NikhilMSeb/ECE445-FA21-Solar/src/445-website/README.md

This folder contains all the code used to design and implement the Django framework front-end and back-end for this project. \
(Running server at this folder level will start the project on localhost!)
