NikhilMSeb/ECE445-FA21-Solar/notebooks/sydneyl3/README.md

# ECE 445 Lab Notebook: Sydney Li

## Entries 
[08/24/2021: Project Ideas and Team Finding](#08242021-project-ideas-and-team-finding) \
[08/25/2021: Gathering Additional Information](#08252021-gathering-additional-information) \
[08/30/2021: Finding a Third Member](#08302021-finding-a-third-member) \
[09/01/2021: First Meeting With Professor Banerjee](#09012021-first-meeting-with-professor-banerjee) \
[09/08/2021: Solar Panel Research](#09082021-solar-panel-research) \
[09/13/2021: First TA Meeting](#09132021-first-ta-meeting) \
[09/14/2021 - 09/15/2021: Microcontroller Research and Design Proposal](#09142021---09152021-microcontroller-research-and-design-proposal) \
[09/17/2021: ESP32 Microcontroller](#09172021-esp32-microcontroller) \
[09/22/2021 - 09/26/2021: First Design Document Draft](#09222021---09262021-first-design-document-draft) \
[09/27/2021: Design Document Check and Rooftop Visit](#09272021-design-document-check-and-rooftop-visit) \
[09/30/2021: Final Version of Design Document](#09302021-final-version-of-design-document) \
[10/07/2021: PCB Schematic Updates](#10072021-pcb-schematic-updates) \
[10/12/2021: Power Subsystem LTSpice Simulations](#10122021-power-subsystem-ltspice-simulations) \
[10/19/2021: Additional PCB Updates](#10192021-additional-pcb-updates) \
[10/21/2021: Implementing the Darlington Array](#10212021-implementing-the-darlington-array) \
[10/27/2021: Design Document Updates](#10272021-design-document-updates) \
[10/29/2021: Finalized Relay Subsystem](#10292021-finalized-relay-subsystem) \
[10/30/2021: PCB Completion](#10302021-pcb-completion) \
[11/07/2021: Drafting the Design Aspect of the Final Paper](#11072021-drafting-the-design-aspect-of-the-final-paper) \
[11/12/2021: Researching the Hardware Communication Aspect of the ESP32](#11122021-researching-the-hardware-communication-aspect-of-the-esp32) \
[11/14/2021: Researching the Hardware Communication Aspect of the ESP32 Part II](#11142021-researching-the-hardware-communication-aspect-of-the-esp32-part-ii) \
[11/19/2021: Part Testing Prior to PCB Arrival](#11192021-part-testing-prior-to-pcb-arrival) \
[11/24/2021: PCB Retrieval and Additional Testing](#11242021-pcb-retrieval-and-additional-testing) \
[11/29/2021: ADC Testing and New Problems](#11292021-adc-testing-and-new-problems) \
[11/30/2021: Fixes and Current Sensor Calibration](#11302021-fixes-and-current-sensor-calibration) \
[12/01/2021: Culmination of the Monitoring Subsystem](#12012021-culmination-of-the-monitoring-subsystem) \
[12/02/2021: Final Demo Presentation](#12022021-final-demo-presentation)

## 08/24/2021: Project Ideas and Team Finding
**Objectives:** Find a team and choose a good project idea to work on over the semester.

**Outcome:** Discovered a mutual friend in the course, Maram Safi and we had similar interests in the project that we wanted to work on. We had already met prior to the course and were taking similar classes this semester. Namely, ECE464 (Power Electronics) and ECE469 (Power Electronics Lab) taught by professor Arijit Banerjee. During the first class meeting, professor Banerjee proposed the idea of a group of students taking on the project working with the research panels on top of ECEB. The project is to implement a smart interface box with protection measures in place to prevent overcurrent, overvoltage, and to shut down the whole operation if temperatures exceed the expected threshold. Since professor Banerjee discussed that this semester, he planned on implementing new labs for ECE469 so that students could do power conversion while harvesting energy from the research panels at an undergraduate level, we thought it would be a great idea if the coursework for this class along with our Power Electronics Lab could go hand-in-hand. As Maram Safi and I are electrical engineers, we need to find a partner that is a computer engineer with advanced software capability and to design a website to fulfill the purposes of the web design and user interface that Professor Banerjee mentioned. There was another group of students who took on this project for their senior design in the Fall 2019 semester but there were certain problems with the design that needed to be solved. There were issues with scalability, to clarify, we hope to soon have a meeting with professor Banerjee and pitch our idea on the RFA board for approval to see if this project within the scope of the course. We hope to ask professor Banerjee for more information in the upcoming days. Another issue to be resolved is the ethernet dependence. The previous design for this project utilized Ethernet to provide communication capability between a portal and the microcontroller of the smart interface box. Professor Banerjee emphasized wireless capabilities and to design a user-friendly website that can be used to configure the solar panels. 

## 08/25/2021: Gathering Additional Information 
**Objectives:** Study professor Banerjee's powerpoint to further my understanding on the project and how brainstorm some ideas or a high level picture as to how we can possibly accomplish it.

**Outcome:** There will be an external 12V power supply available to help us power our smart interface box. There will be four solar panel external inputs coming into the box and two external outputs leading out into a distribution box. The premises for our design will have to measure the voltage, current, temperature, and possibly additional information. Protection measures will have to be instilled. The project has to be scalable meaning that more than one panel's information will be collected on the back-end server of our website.

* Sunpower SPR-425E-WHT-D (425W) Solar Panel

interfacebox

## 08/30/2021: Finding a Third Member 
**Objectives:** Compose our RFA and find a third member for our group.

**Outcome:** Maram and I posted an RFA on the web board stating the premises of what we understand for the project so far. We plan on getting additional information from professor Banerjee on September 1 when he has office hour availabity. A few very talented individuals had requested to join our group and ultimately, we thought that Nikhil would be the best fit for us because he had experience with web design which is one of the key designs that we want for the project. We met this week to establish some form of communication and to understand each others work ethics before taking on this project.

## 09/01/2021: First Meeting With Professor Banerjee
**Objectives:** Meet with professor Banerjee collectively as a group to understand the scope of the project, any additional information or features we will have to implement, and clarify specific details. 

**Outcome:** We were able to meet in Professor Banerjee's office and he mentioned a few things for our project that we should be aware. Prior to the meeting, we understood that there had been a design done during the Fall 2019 semester by a group of students. The issue is that when another senior design group tried to built upon their project, it was a mess because of poor documentation. Therefore, he emphasized that good documentation for our project must be done so in the event that the design is not incomplete or to be improved upon, there will be another group of students who can understand the documentation and to built the project themselves. Another thing is that in order to encourage creativity, we will not be basing our design on the past design as it will bias our thinking and we may run into the issue with scalability again. One thing that I had clarified that I did not know before is that I was under the impression that it would be one interface box responsible for communicating multiple solar panel information but there will be 60 boxes mounted on each solar panel but the scability issue comes from collectively representing multiple solar panel data on the website. He also mentioned that if we go above and beyond with the features we implement, we could possibly implement drones to take thermal images of the solar panels on the roof to provide snapshot data for the users that will use the website from the atrium. 

**Key Takeaways:**
* Build our project from scratch without prior information to encourage creativity
* The scalability and wireless connectivity is a key requirement 
* If these features can be implemented, we can possibly add some more advanced features such as drone thermal imaging

## 09/08/2021: Solar Panel Research
**Objectives:** Brainstorm ideas about the design and research ratings for the solar panels.

**Outcome:** Since the smart interface requires wireless capability, we will need a microcontroller that is able to wirelessly communicate. I am looking into possible microcontrollers that we can use while also being able to have voltage reading capability. Professor Banerjee mentioned that he wanted a more advanced protocol than just arduino to build the website. As the solar panel will connect to the external load, we will need an inverter if that load is an AC grid. A power converter to handle those ratings is necessary and therefore, it is important to understand the max ratings that we can expect to receive with the panel. Professor Banerjee said that to configure the different cells for the solar panel, they are utilizing relays and already have a relay subsystem built to use since the relays are already purchased and can withstand the high voltage from the solar panels. A relay is an switch that closes when the coil is energized and producing an electromagnetic field to close the switch.

* Solar Panel Ratings

sunpower spr-425e-wht-d

## 09/13/2021: First TA Meeting
**Objectives:** Meet our TA and understand the schedule for the upcoming week and a outline of how we can create our project.

**Outcome:** Prior to the meeting, we drafted parts of the proposal that we wanted to show and our TA, Evan Widloski, was able to give us pointers on things that we should consider when building our design. The important thing was to specify our high level requirements and what we hope to achieve with the project. I made a first draft of our block diagram mapping out the design flow and there were many points and specifics that had to be improved upon. A key was to clarify that only one box is to be mounted per solar panel and to capture the solar parameters from there. We labelled different subsystems that we would need. Namely a power subsystem to power up the microcontroller, a power inverter to supply power to the grid, a monitoring subsystem for measuring the voltage and current. Evan suggested that we should do more research on how voltage and current readings are done when not utilizing lab equipment. Methods such as analogRead() on an arguino to measure voltage is one example. Another key bit of information that Evan mentioned would help us with our project is to look at other similar projects that have been done to understand how we can design our own. One mistake that I had made when creating this draft is that the subsystem for wireless communication would be built into our microcontroller. Since we have not decided on a microcontroller at the moment, there was a lot of room for improvement. Many of the designs for the block diagram are not specified and we hope to clarify that in our proposal. We also created a git repository for storing our journal entries. To mediate a lot of the confusion, Evan suggested that we should go onto the ECEB roof to understand and observe which external connections will be provided to us to plan around our design flow. We will email Professor Banerjee to schedule a time with him so that we can observe the rooftop solar panels. 

* First Block Diagram Draft

firstblockdiagram

## 09/14/2021 - 09/15/2021: Microcontroller Research and Design Proposal
**Objectives:** Do research about how similar projects like ours were completed and complete the design proposal. Research possible microcontrollers that can provide us with a wireless interface.

**Outcome:** When doing research upon similar projects monitoring voltage and current from solar panels, I found multiple different MPPT projects utilized to charge lithium batteries. Some similar ones are linked below: 
* [IoT Based Solar Panel Power Monitoring using ESP32 and ThingSpeak](https://circuitdigest.com/microcontroller-projects/iot-solar-panel-power-monitoring-system-using-esp32-and-thingspeak)
* [DIY 1kW Arduino MPPT Solar Charge Controller (WiFi ESP32)](https://www.instructables.com/DIY-1kW-MPPT-Solar-Charge-Controller/)
* [DIY Solar Panel Monitoring System - V1.0](https://www.instructables.com/DIY-Solar-Panel-Monitoring-System-V10/) \
The general consensus when choosing a microcontroller best suited for the needs of monitoring multiple solar panel parameters at a low cost was the ESP32 microcontroller which is what we decided to use. The ESP32 has IoT-enabled application and it will be able to process the data from its analog pins and send the data via any kind of connection protocol such as Wi-Fi or to the cloud server. We specifically selected ESP32 as it is a low-cost microcontroller with tons of features. Also, it has a built-in Wi-Fi radio through which we can connect to the internet very easily.
The second order of business is to understand how voltage and current are going to be read from the solar panels. Since the voltage from the solar panel can be as high as 85.6V in our case, we need a voltage divider to step down the voltage so that the voltage divider output voltage should not exceed the microcontroller maximum I/O voltage (3.3V for ESP32). The output value will be read with one of the analog inputs of Arduino and its analogRead() function. That function outputs a value between 0 and 4095 that is 3.3/4095 for each increment. For current sensing, we can utilize the [Allegro ACS723 current sensor IC](https://www.allegromicro.com/en/products/sense/current-sensor-ics/zero-to-fifty-amp-integrated-conductor-sensor-ics/acs723). It's an economical and precise solution for AC or DC current sensing and good for space constrained applications while also saving costs due to reduced board area. It's typical applications includes overcurrent fault protection which is a key feature of our project.
I also updated our block diagram to specify our subsystems a bit more and to identify which lines represent data or power. The high level requirements I thought that the project should have would be to involve the accuracy of monitoring the solar panel parameters along with wireless capability and scability. I also included what we can expect out of each of the subsystems within the block diagram and specified a bit more of what parts should be included in each. The final document that we put together and submitted can be found within this repository [here](https://github.com/NikhilMSeb/ECE445-FA21-Solar/blob/main/team%20documents/ECE%20445%20Proposal.pdf)

* Second Block Diagram Draft

secondblockdiagram

## 09/17/2021: ESP32 Microcontroller
**Objectives:** Research more specific details and benefits using the ESP32 microcontroller over other microcontrollers. Possible safety concerns will also be crucial to consider when working with high voltages. 

**Outcome:** 
* [ESP32](https://cdn.sparkfun.com/datasheets/IoT/esp32_datasheet_en.pdf) 
  * Wireless Microcontroller (ESP32 MCU): Wi-Fi Connectivity within a large radius. Operates at a temperature range from -40°C to 105°C. 
    * Performs more accurate DC voltage measurements (Analog to Digital Converters with Higher Resolution) - Eighteen 12-bit ADCs
    * Replaced our original design of utilizing an arduino for analog to digital conversion to measure voltage and current 
  * Power Subsystem consists of a Step-Down Buck Converter: Utilized to step down the DC-DC voltage to power up 3.3V/5V LEDs, switches, etc. 
  * Does Digital to Analog and Analog to Digital Conversion
* [ESP8266](https://www.espressif.com/sites/default/files/documentation/0a-esp8266ex_datasheet_en.pdf)
  * Few GPIO pins in which if we utilize a lot of hardware, we will run out of pins
  * 4MB of data storage (unnecessary for our project)
* [WINC1500](https://media.digikey.com/pdf/Data%20Sheets/Microchip%20PDFs/ATWINC15x0.pdf)
  * Low power mobile applications
    * Features: Power amplifier, LNA, Switch and Power Management
    * On chip microcontroller and integrated flash memory for system software
* [Panasonic PAN9520](https://www.mouser.com/pdfDocs/WMPAN9520ProductSpecification.pdf)
   * Many features that we don't need
    * High performance CPU, high sensitivity wireless radio, baseband processor, etc.
    * Out of stock
    * 2.4 GHz WiFi
    * Supports 20MHz and 40MHz bandwidths in 2.4GHz band 

**Safety Concerns:**
* Arc Flashes - Flash Burn and Blast Hazards
* Electric Shock, with particular scrutiny on faulty wiring as well 
* Falls - due to the location itself of the solar panels for this project (ECEB roof)
* Thermal Burn Hazards
* Over-current/voltage - ideally will be directly countered by our interface box 

## 09/22/2021 - 09/26/2021: First Design Document Draft
**Objectives:** Complete our first draft of the Design Document and add any missing information so that the ECE445 course staff can evaluate and provide us with feedback in order to improve our design.

**Outcome:** I was able to do more research about the design structure for the individual subsystems and provided the requirements and verifications for all the hardware aspect of the project. I created a first draft of the PCB schematic so that we have some notion of the parts we may need. The cost analysis was also done when I was considering the base parts that we would need for the structure of the project. Other passive compoenents are missing at the moment and will be added upon and updated as we work through more of the PCB schematic. To demonstrate that we can have 2 interface boxes that can communicate with one another and that the project can be scaled up to multiple panels, our costs would have essentially doubled meaning that we would need to buy 2 of everything. A schedule was also worked out so that I would know what to expect to work on and what deadlines we would try to meet over the next few weeks.

* First PCB Schematic Draft:
firstdraftPCB

* 3 High-Level Requirements: 
   * Interactive Web Design
   * Wireless Communication Capability with the Solar Panels
   * Scalability
* Subsystem Requirement: 
   * Manual Switch Control

* Different Components & Subsystems
   * External 12V Power Supply Unit:
   * Power Subsystem: DC-DC Converter (Possibly a step-down buck converter)
   * Wireless Microcontroller - Control system (Monitors Voltage/Current, communicates that data to our external display, etc.)
   * LED or Hexadecimal Display - Displays whether a wireless connection has been established. Whether power is being integrated into the grid
   * Thermocouples - Monitors the temperature of the panels
   * Switches - Providing external control toward the interface box
   * Monitoring Subsystem - Retrieves voltage/current data from the panels. If overvoltage/overcurrent occurs, implements safety precautions and shuts down completely
   * Communication Subsystem - Capability of interfacing with multiple solar panels. Be able to select the combination of cells to output to the interface (32/64/128 cells)
   * DC-AC Power Inverter - Transfers AC power to the external load (Must be load independent)
            
The uploaded first draft of the Design Document for our project can be found on the ECE 445 Projects page (Team #10) [here](https://courses.engr.illinois.edu/ece445/getfile.asp?id=19521)

## 09/27/2021: Design Document Check and Rooftop Visit
**Objectives:** Meet with Professor Schuh and other TAs to discuss our Design Document progress and further improvements that we can make prior to the design review. Also observe the solar panels on the ECEB rooftop and observe the inputs that will be going into our box and a 12V supply that we will be using. Understand how the boxes will be mounted and which external load the smart interface box will supply. 

**Outcome:** During our design document check with Professor Jonathon Schuh, TA's David Null and Bonhyun Ku, we were able to receive very good feedback on our design document.
The following changes that need to be made include: 
* Have more distinguished subsystems in our block diagram and make it easier for an engineer to look at the block diagram and understand how the design flow operates
* Provide more specific details on our high level requirements such as a
* Include a tolerance range with voltage, current, and temperature readings when testing in our Requirements and Verifications table
* Create a better visual aid in which we can understand how the boxes are mounted onto each panel (After the rooftop visit, we have an understanding on how we can visually represent that)
* Do not use green at all to represent the power flow in the block diagram as it may not be visible on a presentation
* Draft more of the PCB design schematics prior to our PCB board reviews
* Have multiple references cited in IEEE format (around 20 is expected)
* Reformat the tolerance analysis 
* Ensure that each image has a figure attached on the bottom and that tables have a caption

As for the rooftop visit guided by Kevin Colravy, he was able to take us to observe the relay boards that they had already attached to the solar panels. They created boards solely used for configuring the solar panels and these boards consist of the relay configuration that professor Banerjee suggested we utilize in our own project. There are 10 dummy boxes are already attached to the solar panels but are currently not harvesting energy to the grid. As for the external load that we will be supplying, it is purely a passive load mainly composed of resistors so output behavior can be observed and there is no storage capability so although they have the capability of transferring power to the grid, this functionality is not currently active.

* Relay Board Utilized Solely for Configuring the Solar Panels:
attabox

As for adding more details to our PCB design, we are looking for specific parts such as a buck converter when creating our power subsystem (some considerations):
* HiLetgo 5pcs DC-DC 12V to 3.3V 5V Power Module 3.3V 5V 12V Multi Output Voltage Conversion 
   * Converts a 12V dc input to 2 separate 3.3V and 5V dc outputs
* Originally Considering XL7015 dc-dc buck converter module but it converts a maximum voltage rating of 80V to 5V. 2 Issues:
   * The open circuit voltage when operating at 128 cells exceeds 80V (85.6V)
   * There is no option to step down to 3.3V as needed for input voltage for the temperature sensor

With additional research on the full capabilities of the Allegro ACS723 current sensor. It uses a Hall effect sensor to output a voltage relative to the current flowing through the IP+ and IP- pins on the board. The advantage of using a Hall effect sensor, specifically, is that the circuit being sensed and the circuit reading the sensor are electrically isolated meaning that, although your Arduino is running on 5V, the sensed circuit can be operating at higher DC or AC voltages. The Current Sensor Breakout measures both DC and AC currents all the way up to 5A, has full electrical isolation of measured and sensed circuits, and has a base sensitivity of 400mV/A. Although the analog output is adjustable to 80kHz, the bandwidth on the ACS723 Sensor Breakout width filter has been set to 20kHz to reduce noise when using at high gains. The full 80KHz bandwidth that the sensor is capable of can be recovered by closing the JP1 (Bandwidth Select) jumper on the back of the board.
* Note: Although the chip itself is rated for up to 2.4kV (RMS) of isolation, the board has not been designed for such high voltage applications.

## 09/30/2021: Final Version of Design Document
**Objectives:** Update the Design Document utilizing the feedback that we got during our Design Document check and preparing for the final design review. We want to make sure there are no outstanding issues with our design before we handle the completion of the PCB. 

**Outcome:** Further completion of our verifications. Look at which parts are in stock and adjust our PCB schematics on parts that we have available. We removed the ACS723 current sensor and replaced it with a similar [ACS714 current sensor](https://www.digikey.com/en/product-highlight/a/allegro-microsystems/acs714-automotive-grade-hall-effect-current-sensor). Gate drivers were unavailable so we had to adjust our relay configuration.
* [POWER SUBSYSTEM](https://www.ti.com/lit/ds/symlink/lm1117.pdf?HQS=dis-dk-null-digikeymode-dsf-pf-null-wwe&ts=1634572215589):
    * 12V Power Supply:
        * DC Output 12V - May vary ~12V range
        * Step Down Buck Converter (12V to 5V): Constant DC output ~5V range
        * Step Down Buck Converter (12V to 3.3V): Constant DC output ~3.3V range
* [SWITCHING SUBSYSTEM](https://www.mouser.com/datasheet/2/164/ftr_j2-967.pdf):
    * Relay: Open Circuit Test (4 Different Combinations) - Input - Solar Panel (DC Input into Relay - DC Output out of Relay)
        * DC (128 Cells) - AD Configuration: Open Ckt Voltage = 85.6V ± 2V DC Output w/ Variability
        * DC (64 Cells) - BC Configuration: Open Ckt Voltage = 42.8V ± 2V DC Output w/ Variability
        * DC (32 Cells) - CD Configuration: Open Ckt Voltage = 21.4V ± 2V DC Output w/ Variability
        * DC (0 Cells) - XX Configuration: Open Ckt Voltage = 0V 
Note: Variability means that dependent on certain conditions, this voltage will change (weather, sun exposure, etc)
* [MONITORING SUBSYTEM](https://www.digikey.com/en/product-highlight/a/allegro-microsystems/acs714-automotive-grade-hall-effect-current-sensor): 
    * Solar Panel Input: Dependent on which configuration - Output of Relay -> Voltage Divider - Current Divider goes before the Voltage Divider
        * Voltage Divider: Measures Voltage of the Open Ckt Voltage from the Relay (Expect DC Output w/ Variability)
        * Current Divider: Measures Current of the Cell Configuration - ~mA range (Small DC Current Value w/ Variability)
* [MANUAL CONFIGURATION](https://sten-eswitch-13110800-production.s3.amazonaws.com/system/asset/product_line/data_sheet/129/100.pdf): 
    * Switches: 
        * Testing: Do the switches operate how we expect? 
        * Does it change which configuration we have? When the configuration is controlled through software, which one takes precedence?
* [MICROCONTROLLER SUBSYSTEM](https://esp32.com/viewtopic.php?t=13089):
    * ESP32 Microcontroller:     
        * Does this have Wi-Fi Capability enabled?
        * Does it connect to the wireless server that we are creating?
        * Shut down when threshold values are reached 
    * OLED Display:
        * Does the OLED display output real time voltage, current, and temperature values that we are reading through an oscilloscope, through out voltage and current divider?
* [THERMOCOUPLES](https://datasheets.maximintegrated.com/en/ds/DS18B20.pdf):
    * Temperature of different areas on the solar panel

* Updated the Block Diagram in our Design Document:
thirdblockdiagram

The final reviewed draft of our Design Document can be found within this repository [here](https://github.com/NikhilMSeb/ECE445-FA21-Solar/blob/main/team%20documents/ECE%20445%20Design%20Document.pdf)

## 10/07/2021: PCB Schematic Updates
**Objectives:** We updated the PCB schematic with parts that were available. A lot of diodes, current sensors, ADC converters, and gate drivers were out of stock quickly and we had to constantly change our schematic around. There were also issues with our PCB in which we had only one ground connection and if this was the case, we would achieve no isolation between the high voltage side of the solar panels and the microcontroller. 

**Outcome:** The following are updated PCB Schematics
* Power Subsystem: 
powersubsystem
* Relay Subsystem
relaysubsystem
* Microcontroller Subsystem:
esp32microcontroller
* Monitoring Subsystem:
monitoringsubsystem

## 10/12/2021: Power Subsystem LTSpice Simulations
**Objectives:** Perform simulations to ensure that we can produce a proper 3.3V and 5V supply line for our components with the [LM1117 linear regulator](https://www.ti.com/lit/ds/symlink/lm1117.pdf?ts=1637235393492&ref_url=https%253A%252F%252Fwww.google.com%252F). 

**Outcome:** Utilizing the LM1117 adjustable linear regulator can produce a 3.3V and 5V output given a 12V supply. The input capacitor is to improve the transient response and stability whilst output voltage is dependent on which resistors we choose for R1 and R2. The output relationship is:

lm1117
33V
5V

* LTSpice Simulation for the 3.3V power supply line:
image (1) 

* LTSpice Simulation for the 5V power supply line:
 

Both results are as expected and we ideally produce two separate 3.3V and 5V supply lines given our 12V input utilizing the LM1117 linear regulator.

## 10/19/2021: Additional PCB Updates
**Objectives:** After our TA meeting today, Evan provided us valuable advice to fix some problems that we had previously in our PCB schematic. This includes additional research on why we are utilizing the decoder and current relay subsystem in the first place even though the working schematic is provided to us and also alternatives to simplifying our relay configuration. In addition, we need to make some changes to correctly implement isolation in our board. 

**Outcome:** While meeting with Evan this week, he mentioned that to correctly provide isolation between the high voltage side and the microcontroller's side, we need to have separate grounds. Initially, we had the same ground connected to the relay configuration and also the microcontroller which would have negated the purpose of the ADC isolator and prevented us from having galvanic isolation in the first place. Therefore, we need to update the schematic ground connections. Another thing discussed during our meeting was to explain how the relay configuration would work. There are two output pins connecting to the external load named POS_Output and NEG_Output. As the configurations of the solar cells are CD (32-cells), BC (64-cells), and AD (128-cells), there will be 3 connections to POS_Output, cell A, B, and C, while the NEG_Output will have 2 connections, cells C and D. The control signals from the ESP32 will be coming from the GPIO pins and the gate drivers will amplify the voltage to 12V which is the switching voltage of the relays. 
This is the current functionality of the relay subsystem but Evan proposed to have our control signals output directly from the ESP32 without utilizing a decoder. We will do research on both to figure out if this replacement can be done to simplify our circuit in order to have less parts on the board. This is important because if this turns out to be a project that we can scale up to 60 solar panels, then we need to consider reducing costs for a singular solar panel and to ensure less power loss due to the added number of components.

The [ESP32 microcontroller](https://components101.com/sites/default/files/component_datasheet/ESP32%20Datasheet.pdf) has 39 digital pins - 34 can be used as GPIO and the remaining are input only pins. 2 inputs - 4 outputs - 1 control signal (ESP32)
   * 18-channels for 12-bit ADC 
   * 2-channel for 8-bit DAC
   * 16 channels for PWM signal generation  
   * 10 GPIO pins supports capacitive features
* The ESP32 has multiplexing feature, this enables the programmer to configure any GPIO pin for PWM or other serial communication through program
* The ESP32 supports 3 SPI Interface, 3 UART interface, 2 I2C interface, 2 I2S interface and also supports CAN protocol.

3 UART interface: The ESP32 supports 3 UART interface for TTL communication. This would require 3 sets of Rx and Tx pins. All the 6 pins are software configurable and hence any GPIO pin can be programmed to be used for UART.
* External Interrupt: Again since the ESP32 supports multiplexing any GPIO pin can be programmed to be used as an interrupt pin.
* GPIO23 (MOSI), GPIO19(MISO), GPIO18(CLK) and GPIO5 (CS): These pins are used for SPI communication. ESP32 supports two SPI, this is the first set.
* GPIO13 (MOSI), GPIO12(MISO), GPIO14(CLK) and GPIO15 (CS): These pins are used for SPI communication. ESP32 supports two SPI, this is the second set.
* GPIO21(SDA), GPIO22(SCL): Used for IIC communication using Wire library.
* Reset Pin: The reset pin for ESP32 is the Enable (EN) pin. Making this pin LOW, resets the microcontroller.

Connecting ESP32 with our Relay Configuration. Control signal from ESP32 & Manual Switch override will have to dictate configuration that inputs into current sensor
   * If utilizing manual switch configuration - involved programming to determines which signal is read

Power Flow: Solar Panels -> 6 pin screw on PCB ->  3 FTR-J2 Series Relays -> MCP1407 High Speed Power MOSFET Drivers -> SN74HC139-Q1 2-to-4 MUX ->  ESP32
Solar Panel output connects to the current sensor prior to going through the voltage sensor (divider)
* ACS723 Current Sensor

Utilizing a Automotive Catalog [SN74HC129DSO16 Dual 2-Line to 4-Line Decoder/Demultiplexor](https://www.ti.com/lit/ds/symlink/sn74hc139-q1.pdf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):
* 2 Inputs: 1A 2A / 1B 2B / 1G 2G
   * 1A 2A - First bit of control signal from ESP32 I2C
   * 1B 2B - Second bit of control signal from ESP32 I2C
   * 1G 2G - GND 
* Operation: 2 inputs, 4 outputs
   * 00: Unused XX configuration (0 cells)
   * 01: CD configuration (32 cells)
   * 10: BC configuration (64 cells)
   * 11: AD configuration (128 cells)
      * 1Y0/2Y0: X X (Open Ckt)
      * 1Y1/2Y1: C_POS D_NEG = CD (32 cells)
      * 1Y2/2Y2: B_POS C_NEG = BC (64 cells)
      * 1Y3/2Y3: A_POS D_NEG = AD (128 cells)
I2C is a serial communication protocol, so data is transferred bit by bit along a single wire (the SDA line). Like SPI, I2C is synchronous, so the output of bits is 
synchronized to the sampling of bits by a clock signal shared between the master and the slave. The clock signal is always controlled by the master.
* Planning on utilize I2C pins to program the 2 inputs to the decoder
   * Pinout depending on the specific [ESP32 Devboard Model](https://randomnerdtutorials.com/esp32-pinout-reference-gpios/) we decide to use
      * Based: Pins 16-33 work well for ADC/DAC input/output
      * Program 2 pins for decoder input (Code I2C capability)

## 10/21/2021: Implementing the Darlington Array
**Objectives:** The goal is to reduce the amount of components in our relay subsystem to reduce overall costs that can add up to a lot if this project is scaled to 60 solar panels. Secondly, learn how to use the darlington array and implement that in place of the inverting IC, decoder, and the gate drivers.

**Outcome:** After our TA meeting, Evan proposed a good idea to simplify our circuit especially when doing board layout was the Darlington Array ULN2003a. Instead of multiple additional components on the board, we'd have one IC that can drive the the relays utilizing control signals from the ESP32 microcontroller. The Darlington Array is a high-voltage, high-current switch array containing multiple open-collector Darlington transistors with common emitters, and integrated flyback diodes for inductive loads. This is good for our relays because since the coil in the relay cannot instantly change its current, a freewheeling diode is placed in parallel to the relay's inductance coil so that it prevents huge voltage spikes from arising when the power supply is suddenly disconnected. 

* Implementing the Darlington Array 
image (3)

## 10/27/2021: Design Document Updates
**Objectives:** After receiving feedback from Editorial Services regarding our Design Document, there were quite a bit of formatting issues that we needed to fix prior to our Final Paper. Some parts of the paper seemed ambiguous and needed additional details so the goal was to work on improving and also doing additional revisions to finalize different components of our Design Document. 

**Outcome:** Many changes were included into the design document. One key detail was that our subsystems were not correctly organized and in our block diagram, it was good to have multiple subsystems instead of just simply components. Therefore, I updated and made specific flow lines and details so that the power and data flow could be easily followed along with understanding which components were included. I also updated the requirements and verifications for the hardware aspect of the design document and our high-level requirements needed to be changed because prior, they were solely based on the assumption that the solar panel could even achieve it's max voltage of 85.6V and that we would be taking measurement with that voltage. This is not the case and so, our solar panel parameter measurements are based on how accurate it can be compared to the measurements taken in a lab environment. 

* Final Block Diagram


## 10/29/2021: Finalized Relay Subsystem
**Objective:** Fix the implementation of the darlington array in our circuit.

**Outcome:** After some feedback provided to Maram and I from Evan, he had mentioned we have incorrectly wired the Darlington Array in our circuit. To mend this issue, I read the datasheet on how to wire the Darlington Array when utilizing it to control a set of relays. In addition, when I had placed the part order, I noticed that the ULN2003a Darlington was out of stock so I chose an alternative [ULN2003BDR](https://www.ti.com/lit/ds/symlink/uln2003b.pdf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).

* [ULN2003 Driving a Set of Relays](https://www.bristolwatch.com/ele/uln2003a.htm)
uln2003a_6

I re-implemented the Darlington Array in a similar fashion and mapped out the control signals and relays to the appropriate pins. 
image (2)

Therefore, our finalized Relay Subsystem is mapped out on the following schematic: 
image (5)

## 10/30/2021: PCB Completion
**Objective:** Maram and I worked together to complete and finalize the board layout together while correcting mistakes that Evan had noticed with our board layout.

**Outcome:** The following updates were made in the board layout:
* Isolate the high current traces to one side of the board
* Add bigger VIAs for higher current traces
* Thicken traces from 12V (Replace barrel jack with a pin screw terminal)
* High voltage screw terminals for the solar panel side like a 1x04 + a 1x02 for the output load
* Thicken power traces
* ACS723 needs GND1
Once we finalized the PCB and got it approved, we moved onto the ordering phase of the project which we were kindly provided by Professor Banerjee and his team.

## 11/07/2021: Drafting the Design Aspect of the Final Paper
**Objective:** After the completion of the PCB design, we can draft in the design process into our Final Paper

**Outcome:** I have evolved and taken additional data from our refined Design Document to forge a first draft of our Final Paper. Especially correcting the language and format provided by ECE Editorial Services to assist us on having an organized paper with proper technical content.

## 11/12/2021: Researching the Hardware Communication Aspect of the ESP32
**Objectives:** While awaiting PCB orders, it is a good idea to do research on finding some code as to how the ESP32 can read voltage/current readings while also communicating with the ADC isolator and the OLED (I2C)

**Outcome:** Our voltage reading pin is through SCL and SDA from the ADC isolator. There is a [tutorial online](https://microcontrollerslab.com/ads1115-external-adc-with-esp32/) that communicated with an ADS1115 external ADC and it is a 16-bit ADC that can measure voltage at a higher resolution. 

1. Arduino IDE will program the ESP32 and we would have to look up and install the library of our ADC [MCP3428-E/SL](https://ww1.microchip.com/downloads/en/DeviceDoc/22226a.pdf) 
). It is also 16-bit.

The following link has the libraries available for microchip ADC342: https://www.arduino.cc/reference/en/libraries/mcp342x/

Examples for different functionalities included: https://github.com/stevemarple/MCP342x

```
#include <Wire.h>
#include <MCP342x.h>

/* Demonstrate the use of read() and convert(). If read() is called
 * immediately after convert then the conversion will not have
 * completed. Two approaches to avoid this problem are possible, use
 * delay() or similar to wait a fixed amount of time, or to
 * periodically read the device and check the config result.
 */

// 0x68 is the default address for all MCP342x devices
uint8_t address = 0x6E;
MCP342x adc = MCP342x(address);

// Configuration settings
MCP342x::Config config(MCP342x::channel1, MCP342x::oneShot,
		       MCP342x::resolution18, MCP342x::gain1);

// Configuration/status read back from the ADC
MCP342x::Config status;

// Inidicate if a new conversion should be started
bool startConversion = false;

// LED details
#ifdef LED_BUILTIN
int led = LED_BUILTIN;
#else
int led = 13;
#endif
bool ledLevel = false;

void setup(void)
{
  Serial.begin(9600);
  Wire.begin();

  // Enable power for MCP342x (needed for FL100 shield only)
  pinMode(9, OUTPUT);
  digitalWrite(9, HIGH);
  
  pinMode(led, OUTPUT);
    
  // Reset devices
  MCP342x::generalCallReset();
  delay(1); // MC342x needs 300us to settle
  
  // Check device present
  Wire.requestFrom(address, (uint8_t)1);
  if (!Wire.available()) {
    Serial.print("No device found at address ");
    Serial.println(address, HEX);
    while (1)
      ;
  }

  // First time loop() is called start a conversion
  startConversion = true;
}

unsigned long lastLedFlash = 0;
void loop(void)
{
  long value = 0;
  uint8_t err;

  if (startConversion) {
    Serial.println("Convert");
    err = adc.convert(config);
    if (err) {
      Serial.print("Convert error: ");
      Serial.println(err);
    }
    startConversion = false;
  }
  
  err = adc.read(value, status);
  if (!err && status.isReady()) { 
    // For debugging purposes print the return value.
    Serial.print("Value: ");
    Serial.println(value);
    Serial.print("Config: 0x");
    Serial.println((int)config, HEX);
    Serial.print("Convert error: ");
    Serial.println(err);
    startConversion = true;
  }

  // Do other stuff here, such as flash an LED
  if (millis() - lastLedFlash > 50) {
    ledLevel = !ledLevel;
    digitalWrite(led, ledLevel);
    lastLedFlash = millis();
  }
    
}
```

As for monitoring temperature with the ESP32 and the DS18B20 thermocouples, it only requires one data line to communicate with our ESP32. There is a [direct tutorial](https://randomnerdtutorials.com/esp32-ds18b20-temperature-arduino-ide/) for that.

Again, the library for the DS18B20 temperature sensor would have to be installed. 

```
#include <OneWire.h>
#include <DallasTemperature.h>

// GPIO where the DS18B20 is connected to
const int oneWireBus = 4;     

// Setup a oneWire instance to communicate with any OneWire devices
OneWire oneWire(oneWireBus);

// Pass our oneWire reference to Dallas Temperature sensor 
DallasTemperature sensors(&oneWire);

void setup() {
  // Start the Serial Monitor
  Serial.begin(115200);
  // Start the DS18B20 sensor
  sensors.begin();
}

void loop() {
  sensors.requestTemperatures(); 
  float temperatureC = sensors.getTempCByIndex(0);
  float temperatureF = sensors.getTempFByIndex(0);
  Serial.print(temperatureC);
  Serial.println("ºC");
  Serial.print(temperatureF);
  Serial.println("ºF");
  delay(5000);
}
```

Since we have multiple thermocouples, we want to measure more than one digital temperature measurement:
```
#include <OneWire.h>
#include <DallasTemperature.h>

// Data wire is plugged TO GPIO 4
#define ONE_WIRE_BUS 4

// Setup a oneWire instance to communicate with any OneWire devices (not just Maxim/Dallas temperature ICs)
OneWire oneWire(ONE_WIRE_BUS);

// Pass our oneWire reference to Dallas Temperature. 
DallasTemperature sensors(&oneWire);

// Number of temperature devices found
int numberOfDevices;

// We'll use this variable to store a found device address
DeviceAddress tempDeviceAddress; 

void setup(){
  // start serial port
  Serial.begin(115200);
  
  // Start up the library
  sensors.begin();
  
  // Grab a count of devices on the wire
  numberOfDevices = sensors.getDeviceCount();
  
  // locate devices on the bus
  Serial.print("Locating devices...");
  Serial.print("Found ");
  Serial.print(numberOfDevices, DEC);
  Serial.println(" devices.");

  // Loop through each device, print out address
  for(int i=0;i<numberOfDevices; i++){
    // Search the wire for address
    if(sensors.getAddress(tempDeviceAddress, i)){
      Serial.print("Found device ");
      Serial.print(i, DEC);
      Serial.print(" with address: ");
      printAddress(tempDeviceAddress);
      Serial.println();
    } else {
      Serial.print("Found ghost device at ");
      Serial.print(i, DEC);
      Serial.print(" but could not detect address. Check power and cabling");
    }
  }
}

void loop(){ 
  sensors.requestTemperatures(); // Send the command to get temperatures
  
  // Loop through each device, print out temperature data
  for(int i=0;i<numberOfDevices; i++){
    // Search the wire for address
    if(sensors.getAddress(tempDeviceAddress, i)){
      // Output the device ID
      Serial.print("Temperature for device: ");
      Serial.println(i,DEC);
      // Print the data
      float tempC = sensors.getTempC(tempDeviceAddress);
      Serial.print("Temp C: ");
      Serial.print(tempC);
      Serial.print(" Temp F: ");
      Serial.println(DallasTemperature::toFahrenheit(tempC)); // Converts tempC to Fahrenheit
    }
  }
  delay(5000);
}

// function to print a device address
void printAddress(DeviceAddress deviceAddress) {
  for (uint8_t i = 0; i < 8; i++){
    if (deviceAddress[i] < 16) Serial.print("0");
      Serial.print(deviceAddress[i], HEX);
  }
}
```

Our final method of communication involves the ESP32 microcontroller communicating with the OLED display. Again, there is a provided [tutorial](https://randomnerdtutorials.com/esp32-ssd1306-oled-display-arduino-ide/) on the communication aspect between the ESP32 and the OLED. The following code is simply to test out our OLED display prior to giving it command for writing text. 

We can utilize one of the Adafruit_SSD1306 libraries or the Adafruit_GFX library to install the SSD1306 oled driver. 

```
#include <SPI.h>
#include <Wire.h>
#include <Adafruit_GFX.h>
#include <Adafruit_SSD1306.h>

#define SCREEN_WIDTH 128 // OLED display width, in pixels
#define SCREEN_HEIGHT 64 // OLED display height, in pixels

// Declaration for an SSD1306 display connected to I2C (SDA, SCL pins)
#define OLED_RESET     -1 // Reset pin # (or -1 if sharing Arduino reset pin)
Adafruit_SSD1306 display(SCREEN_WIDTH, SCREEN_HEIGHT, &Wire, OLED_RESET);

#define NUMFLAKES     10 // Number of snowflakes in the animation example

#define LOGO_HEIGHT   16
#define LOGO_WIDTH    16
static const unsigned char PROGMEM logo_bmp[] =
{ B00000000, B11000000,
  B00000001, B11000000,
  B00000001, B11000000,
  B00000011, B11100000,
  B11110011, B11100000,
  B11111110, B11111000,
  B01111110, B11111111,
  B00110011, B10011111,
  B00011111, B11111100,
  B00001101, B01110000,
  B00011011, B10100000,
  B00111111, B11100000,
  B00111111, B11110000,
  B01111100, B11110000,
  B01110000, B01110000,
  B00000000, B00110000 };

void setup() {
  Serial.begin(115200);

  // SSD1306_SWITCHCAPVCC = generate display voltage from 3.3V internally
  if(!display.begin(SSD1306_SWITCHCAPVCC, 0x3C)) { 
    Serial.println(F("SSD1306 allocation failed"));
    for(;;); // Don't proceed, loop forever
  }

  // Show initial display buffer contents on the screen --
  // the library initializes this with an Adafruit splash screen.
  display.display();
  delay(2000); // Pause for 2 seconds

  // Clear the buffer
  display.clearDisplay();

  // Draw a single pixel in white
  display.drawPixel(10, 10, WHITE);

  // Show the display buffer on the screen. You MUST call display() after
  // drawing commands to make them visible on screen!
  display.display();
  delay(2000);
  // display.display() is NOT necessary after every single drawing command,
  // unless that's what you want...rather, you can batch up a bunch of
  // drawing operations and then update the screen all at once by calling
  // display.display(). These examples demonstrate both approaches...

  testdrawline();      // Draw many lines

  testdrawrect();      // Draw rectangles (outlines)

  testfillrect();      // Draw rectangles (filled)

  testdrawcircle();    // Draw circles (outlines)

  testfillcircle();    // Draw circles (filled)

  testdrawroundrect(); // Draw rounded rectangles (outlines)

  testfillroundrect(); // Draw rounded rectangles (filled)

  testdrawtriangle();  // Draw triangles (outlines)

  testfilltriangle();  // Draw triangles (filled)

  testdrawchar();      // Draw characters of the default font

  testdrawstyles();    // Draw 'stylized' characters

  testscrolltext();    // Draw scrolling text

  testdrawbitmap();    // Draw a small bitmap image

  // Invert and restore display, pausing in-between
  display.invertDisplay(true);
  delay(1000);
  display.invertDisplay(false);
  delay(1000);

  testanimate(logo_bmp, LOGO_WIDTH, LOGO_HEIGHT); // Animate bitmaps
}

void loop() {
}

void testdrawline() {
  int16_t i;

  display.clearDisplay(); // Clear display buffer

  for(i=0; i<display.width(); i+=4) {
    display.drawLine(0, 0, i, display.height()-1, WHITE);
    display.display(); // Update screen with each newly-drawn line
    delay(1);
  }
  for(i=0; i<display.height(); i+=4) {
    display.drawLine(0, 0, display.width()-1, i, WHITE);
    display.display();
    delay(1);
  }
  delay(250);

  display.clearDisplay();

  for(i=0; i<display.width(); i+=4) {
    display.drawLine(0, display.height()-1, i, 0, WHITE);
    display.display();
    delay(1);
  }
  for(i=display.height()-1; i>=0; i-=4) {
    display.drawLine(0, display.height()-1, display.width()-1, i, WHITE);
    display.display();
    delay(1);
  }
  delay(250);

  display.clearDisplay();

  for(i=display.width()-1; i>=0; i-=4) {
    display.drawLine(display.width()-1, display.height()-1, i, 0, WHITE);
    display.display();
    delay(1);
  }
  for(i=display.height()-1; i>=0; i-=4) {
    display.drawLine(display.width()-1, display.height()-1, 0, i, WHITE);
    display.display();
    delay(1);
  }
  delay(250);

  display.clearDisplay();

  for(i=0; i<display.height(); i+=4) {
    display.drawLine(display.width()-1, 0, 0, i, WHITE);
    display.display();
    delay(1);
  }
  for(i=0; i<display.width(); i+=4) {
    display.drawLine(display.width()-1, 0, i, display.height()-1, WHITE);
    display.display();
    delay(1);
  }

  delay(2000); // Pause for 2 seconds
}

void testdrawrect(void) {
  display.clearDisplay();

  for(int16_t i=0; i<display.height()/2; i+=2) {
    display.drawRect(i, i, display.width()-2*i, display.height()-2*i, WHITE);
    display.display(); // Update screen with each newly-drawn rectangle
    delay(1);
  }

  delay(2000);
}

void testfillrect(void) {
  display.clearDisplay();

  for(int16_t i=0; i<display.height()/2; i+=3) {
    // The INVERSE color is used so rectangles alternate white/black
    display.fillRect(i, i, display.width()-i*2, display.height()-i*2, INVERSE);
    display.display(); // Update screen with each newly-drawn rectangle
    delay(1);
  }

  delay(2000);
}

void testdrawcircle(void) {
  display.clearDisplay();

  for(int16_t i=0; i<max(display.width(),display.height())/2; i+=2) {
    display.drawCircle(display.width()/2, display.height()/2, i, WHITE);
    display.display();
    delay(1);
  }

  delay(2000);
}

void testfillcircle(void) {
  display.clearDisplay();

  for(int16_t i=max(display.width(),display.height())/2; i>0; i-=3) {
    // The INVERSE color is used so circles alternate white/black
    display.fillCircle(display.width() / 2, display.height() / 2, i, INVERSE);
    display.display(); // Update screen with each newly-drawn circle
    delay(1);
  }

  delay(2000);
}

void testdrawroundrect(void) {
  display.clearDisplay();

  for(int16_t i=0; i<display.height()/2-2; i+=2) {
    display.drawRoundRect(i, i, display.width()-2*i, display.height()-2*i,
      display.height()/4, WHITE);
    display.display();
    delay(1);
  }

  delay(2000);
}

void testfillroundrect(void) {
  display.clearDisplay();

  for(int16_t i=0; i<display.height()/2-2; i+=2) {
    // The INVERSE color is used so round-rects alternate white/black
    display.fillRoundRect(i, i, display.width()-2*i, display.height()-2*i,
      display.height()/4, INVERSE);
    display.display();
    delay(1);
  }

  delay(2000);
}

void testdrawtriangle(void) {
  display.clearDisplay();

  for(int16_t i=0; i<max(display.width(),display.height())/2; i+=5) {
    display.drawTriangle(
      display.width()/2  , display.height()/2-i,
      display.width()/2-i, display.height()/2+i,
      display.width()/2+i, display.height()/2+i, WHITE);
    display.display();
    delay(1);
  }

  delay(2000);
}

void testfilltriangle(void) {
  display.clearDisplay();

  for(int16_t i=max(display.width(),display.height())/2; i>0; i-=5) {
    // The INVERSE color is used so triangles alternate white/black
    display.fillTriangle(
      display.width()/2  , display.height()/2-i,
      display.width()/2-i, display.height()/2+i,
      display.width()/2+i, display.height()/2+i, INVERSE);
    display.display();
    delay(1);
  }

  delay(2000);
}

void testdrawchar(void) {
  display.clearDisplay();

  display.setTextSize(1);      // Normal 1:1 pixel scale
  display.setTextColor(WHITE); // Draw white text
  display.setCursor(0, 0);     // Start at top-left corner
  display.cp437(true);         // Use full 256 char 'Code Page 437' font

  // Not all the characters will fit on the display. This is normal.
  // Library will draw what it can and the rest will be clipped.
  for(int16_t i=0; i<256; i++) {
    if(i == '\n') display.write(' ');
    else          display.write(i);
  }

  display.display();
  delay(2000);
}

void testdrawstyles(void) {
  display.clearDisplay();

  display.setTextSize(1);             // Normal 1:1 pixel scale
  display.setTextColor(WHITE);        // Draw white text
  display.setCursor(0,0);             // Start at top-left corner
  display.println(F("Hello, world!"));

  display.setTextColor(BLACK, WHITE); // Draw 'inverse' text
  display.println(3.141592);

  display.setTextSize(2);             // Draw 2X-scale text
  display.setTextColor(WHITE);
  display.print(F("0x")); display.println(0xDEADBEEF, HEX);

  display.display();
  delay(2000);
}

void testscrolltext(void) {
  display.clearDisplay();

  display.setTextSize(2); // Draw 2X-scale text
  display.setTextColor(WHITE);
  display.setCursor(10, 0);
  display.println(F("scroll"));
  display.display();      // Show initial text
  delay(100);

  // Scroll in various directions, pausing in-between:
  display.startscrollright(0x00, 0x0F);
  delay(2000);
  display.stopscroll();
  delay(1000);
  display.startscrollleft(0x00, 0x0F);
  delay(2000);
  display.stopscroll();
  delay(1000);
  display.startscrolldiagright(0x00, 0x07);
  delay(2000);
  display.startscrolldiagleft(0x00, 0x07);
  delay(2000);
  display.stopscroll();
  delay(1000);
}

void testdrawbitmap(void) {
  display.clearDisplay();

  display.drawBitmap(
    (display.width()  - LOGO_WIDTH ) / 2,
    (display.height() - LOGO_HEIGHT) / 2,
    logo_bmp, LOGO_WIDTH, LOGO_HEIGHT, 1);
  display.display();
  delay(1000);
}

#define XPOS   0 // Indexes into the 'icons' array in function below
#define YPOS   1
#define DELTAY 2

void testanimate(const uint8_t *bitmap, uint8_t w, uint8_t h) {
  int8_t f, icons[NUMFLAKES][3];

  // Initialize 'snowflake' positions
  for(f=0; f< NUMFLAKES; f++) {
    icons[f][XPOS]   = random(1 - LOGO_WIDTH, display.width());
    icons[f][YPOS]   = -LOGO_HEIGHT;
    icons[f][DELTAY] = random(1, 6);
    Serial.print(F("x: "));
    Serial.print(icons[f][XPOS], DEC);
    Serial.print(F(" y: "));
    Serial.print(icons[f][YPOS], DEC);
    Serial.print(F(" dy: "));
    Serial.println(icons[f][DELTAY], DEC);
  }

  for(;;) { // Loop forever...
    display.clearDisplay(); // Clear the display buffer

    // Draw each snowflake:
    for(f=0; f< NUMFLAKES; f++) {
      display.drawBitmap(icons[f][XPOS], icons[f][YPOS], bitmap, w, h, WHITE);
    }

    display.display(); // Show the display buffer on the screen
    delay(200);        // Pause for 1/10 second

    // Then update coordinates of each flake...
    for(f=0; f< NUMFLAKES; f++) {
      icons[f][YPOS] += icons[f][DELTAY];
      // If snowflake is off the bottom of the screen...
      if (icons[f][YPOS] >= display.height()) {
        // Reinitialize to a random position, just off the top
        icons[f][XPOS]   = random(1 - LOGO_WIDTH, display.width());
        icons[f][YPOS]   = -LOGO_HEIGHT;
        icons[f][DELTAY] = random(1, 6);
      }
    }
  }
}
```

Since our OLED has no reset, we can define a OLED_Reset command with:

`#define OLED_RESET -1 // Reset pin # (or -1 if sharing Arduino reset pin)`

To write text to the OLED display, we would have to modify this code to include our voltage, current, and temperature measurements to display those. 

```
#include <Wire.h>
#include <Adafruit_GFX.h>
#include <Adafruit_SSD1306.h>

#define SCREEN_WIDTH 128 // OLED display width, in pixels
#define SCREEN_HEIGHT 64 // OLED display height, in pixels

// Declaration for an SSD1306 display connected to I2C (SDA, SCL pins)
Adafruit_SSD1306 display(SCREEN_WIDTH, SCREEN_HEIGHT, &Wire, -1);

void setup() {
  Serial.begin(115200);

  if(!display.begin(SSD1306_SWITCHCAPVCC, 0x3C)) { // Address 0x3D for 128x64
    Serial.println(F("SSD1306 allocation failed"));
    for(;;);
  }
  delay(2000);
  display.clearDisplay();

  display.setTextSize(1);
  display.setTextColor(WHITE);
  display.setCursor(0, 10);
  // Display static text
  display.println("Hello, world!");
  display.display(); 
}

void loop() {
  
}
```

## 11/14/2021: Researching the Hardware Communication Aspect of the ESP32 Part II
**Objective:** Research more on how the ESP32 can communicate with the ADC isolator and also how the ESP32 can send high and low signals to the Darlington array to trigger close the switches of our relays.

**Outcome:** We did additional research for the ADC isolator because there was not a specific tutorial that explained how an ESP32 microcontroller could communicate with the specific ADC that we chose to utilize in our project. However, we researched and looked at the libraries to gain better insight by looking at how the microcontroller communicated with different ADCs and sampled code from there for our project. 

Programming the ADC:
Linked [github for MCP342 code from MCP342 library's website](https://github.com/stevemarple/MCP342x)
ESP-IDF compatible library for using the MCP342X series of ADCs with i2c interface linked [here](https://github.com/craftmetrics/esp32-mcp342x)

[Read Loop from Github](https://github.com/uChip/MCP342X)

```
// Include libraries this sketch will use
#include  <Wire.h>
#include  <MCP342X.h>

// Instantiate objects used in this project
MCP342X myADC;

void setup() {
  Wire.begin();  // join I2C bus
  TWBR = 12;  // 400 kHz (maximum)
  
  Serial.begin(9600); // Open serial connection to send info to the host
  while (!Serial) {}  // wait for Serial comms to become ready
  Serial.println("Starting up");
  Serial.println("Testing device connection...");
    Serial.println(myADC.testConnection() ? "MCP342X connection successful" : "MCP342X connection failed");
    
  myADC.configure( MCP342X_MODE_CONTINUOUS |
                   MCP342X_CHANNEL_1 |
                   MCP342X_SIZE_16BIT |
                   MCP342X_GAIN_1X
                 );

  Serial.println(myADC.getConfigRegShdw(), HEX);
  
}  // End of setup()

void loop() {
  static int16_t  result;
  
  myADC.startConversion();
  myADC.getResult(&result);
  
  Serial.println(result, HEX);
  
}  // End of loop()
```

Another communication aspect of the project we had to research was sending a high and low signal to the Darlington Array so it could switch close the relays. Since in our schematic, we noticed that the control signals we utilized did not exactly line up with the output of the corresponding Darlington pair, we had to do some mapping of the control signals and cross couple some nodes in order to get the configurations we wanted from the solar panels. 

We utilized a ULN2003BDR and looking at the datasheet for the [ULN2003B Darlington Array](https://www.ti.com/lit/ds/symlink/uln2003b.pdf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), the input voltage can be around a range of 2.7V to 3V and with the current input resistor value of 2.7k ohms, I wanted to ensure that the Darlington Array could withstand a voltage coming from the ESP32 control signals of around a max of 3.3V. Whilst researching that, I came across different ways that others have utilized the ESP32 and coded it to work with the Darlington Array.

A [tutorial](https://randomnerdtutorials.com/esp32-stepper-motor-28byj-48-uln2003/) I found uses the ESP32 to communicate with the ULN2003a as then to a motor driver. The Darlington has motor drive applications along with driving relays and the latter is what we are specifically utilizing our Darlington Array for. Therefore, we can modify this code to work with 6 Darlington Pairs and drive 6 of our relays.

## 11/19/2021: Part Testing Prior to PCB Arrival
**Objectives:** With awaiting the arrival of the PCB, we did not want to waste the little amount of time we had and with the hardware aspect being seemingly finished, we wanted to still work on as much testing as we could. Especially with core functionalities in the subsystems such as having the ESP32 microcontroller being able to communicate on the hardware aspect of the project and testing out the different subsystems and going from there. Since most of our parts were surface mounts, testing it on a breadboard would be tough and we were generously provided some SMD breakout boards by Evan to assist with the ADC and Darlington tests. 

**Outcome:** As a result, we were able to get the ESP32 to communicate with the Darlington and to switch close the relays on the breadboard. We attached a DC voltage source to the relay switch and if the ESP32 was outputting the correct control signals to the darlington, we would see that voltage at the output of the relay when switched closed. This worked successfully and we were able to verify that the Darlington Array worked in conjunction with the relays and the ESP32 microcontroller.

The second test that we wanted to work on before the PCB arrived is ADC communication with the isolator and the ESP32. This was difficult for us because we were having issues even detecting the isolator and once that was resolved, there were still many issues that we observed such as observing the incorrect signals on the SDA and SCL pins. We hope to resolve these issues in the upcoming week prior to receiving the PCB and complete the software side of the programming so most of the focus once we receive all the parts and the board can be sorted out efficiently.

## 11/24/2021: PCB Retrieval and Additional Testing
**Objectives:** Test the subsystems which mostly include surface mount components guided by the verifications table from our Design Document. We want to solder the parts that we can that don't involve ESP32 hardware communication unless it has been tested and proven to work as expected. The hardware communication that has been verified involves the OLED, thermocouples, darlington array, and the relays so those components could be soldered onto our PCB. Since the power subsystem included surface mount linear regulators, I held off on the testing until this point and was able to resolve some new issues discovered within our schematic. 

**Outcome:** I started off with soldering the Power Subsystem, that included all the passive components, the linear regulator, and we applied a 12V source input so that we could test it. However, when I was reading the output voltage of the 3.3V and 5V linear regulators, they were not producing the expected voltage and had a voltage output of around 10.9V. This was too high and would not work especially since having a output voltage of 10.9V would fry most of our components. After further research, we realized that we had fixed linear regulators and the schematic of our PCB was created under the assumption that we would have adjustable output linear regulators. To mend this issue, we just simply had to remove all the passive components except for a 10uF capacitor at the output voltage. I also had to solder and short some pads together so that we had the guided circuit design in the datasheet and after fixing and testing out the regulators, we retrieved the 3.3V output and 5V output as expected. 

* Adjustable Linear Regulator Schematic (Based our PCB design on this):   


* Fixed Linear Regulator Schematic (Adjustments that we had to make): 


Once the power subsystem was debugged, I worked on soldering in the relays, the pin headers for the ESP32, and the Darlington Array. I tested the subsystem to make sure that everything worked as expected after soldering each new component to ensure that there was not a specific component causing a failure within a subsystem that we had already tested. After soldering those components, they all worked fine. The next thing I soldered was the OLED, and this was causing problems with our power subsystem. It took us a long time to debug but for some reason, the 3.3V line of our power subsystem was working fine but the 5V line was dropping to a unexpected voltage output of around 1.3V. 
We thought there may have been a bug with the traces of the components but we created and soldered an identical PCB board with the same duplicate components because we are meant to create 2 PCB boards anyways. With the PCB board soldered and the power subsystem working, we noticed the same issue with the second board.
I was probing all the test points and pins and I finally figured out what was wrong. The OLED was sinking the DC voltage supply to around 3.3V which caused overall issues with the entire power subsystem because the input voltage was not 12V. I had noticed that the trace connecting the 5V output line to power the OLED was being dropped to almost 0V. That's when I noticed that the VCC and the GND pins of the OLED were flipped due to the footprint being incorrect. The OLED has an internal ground that was sinking our DC power supply and it was lucky that we did not burn out any components by connecting a voltage source to its own ground. To mend this issue, we had to cross align wires and solder in a new alignment so that the correct 5V output can be connected to the correct VCC of the OLED and that the ground was connected to GND of the OLED and not to VCC. 

* OLED in our schematic:



* OLED we are using:



Notice how the SDA and SCL pins are aligned but the 5V and GND pins are opposite from the schematic to the pin mapping of the OLED we are using. It is good that we resolved this issue so the power subsystem is not compomised. 

## 11/29/2021: ADC Testing and New Problems
**Objectives:** The goal of today was to debug issues with our ADC prior to our demo and to solder in the components that we had already tested to see if they work on the PCB. 

**Outcome:** To test the communication of the ADC, we simply sent data out of the ESP32 in quick bursts to see if we see the data. Once we were able to do that we had gotten around to sending the data from the SDA and seeing the response from the ADC. When doing this, we were running into issues where the the master was not acknowledging the data from the slave. We were simply seeing a negative acknowledgement from the master. The following image was the waveform of the SDA we were meant to see when we sent a burst of data to the MCP3428. 


Maram and I were also able to speak with Kevin to get some assistance on the best way and where to mount our pull-up resistors for the OLED and thermocouples. Once we were confident, we were able to solder THT resistors onto the bottom layer of the PCB and we began testing the OLED communication with the ESP32 on the board. We also resolved the previous issue with the OLED in which the data on the OLED could constantly refresh without the connection of Nikhil's laptop to the microcontroller. The simple fix was to not just reset the power supply but to enable the microcontroller as well. When we connected the ESP32 and the OLED onto the PCB, we were running into issues where sometimes the ESP32 LED which indicates refreshing of the data would light and sometimes it would not light. The OLED would not turn on unless we soldered in jumper cables directly from the ESP32 to the pin headers soldered into the PCB. This was an add fix that we have yet to resolve but our goal is to figure out the solution the following day with some assistance. 

Additionally, I was able to find code so that we could test our ACS712 current sensor module and sense current with Arduino. Here is the [link](http://robojax.com/node/958) which comes with a video on an explanation for the module and how it operates.  
```
#define VIN A0 // define the Arduino pin A0 as voltage input (V in)
const float VCC   = 5.0;// supply voltage is from 4.5 to 5.5V. Normally 5V.
const int model = 2;   // enter the model number (see below)

float cutOffLimit = 1.01;// set the current which below that value, doesn't matter. Or set 0.5

/*
          "ACS712ELCTR-05B-T",// for model use 0
          "ACS712ELCTR-20A-T",// for model use 1
          "ACS712ELCTR-30A-T"// for model use 2  
sensitivity array is holding the sensitivy of the  ACS712
current sensors. Do not change. All values are from page 5  of data sheet          
*/
float sensitivity[] ={
          0.185,// for ACS712ELCTR-05B-T
          0.100,// for ACS712ELCTR-20A-T
          0.066// for ACS712ELCTR-30A-T
     
         }; 

const float QOV =   0.5 * VCC;// set quiescent Output voltage of 0.5V
float voltage;// internal variable for voltage

void setup() {
    //Robojax.com ACS712 Current Sensor 
    Serial.begin(9600);// initialize serial monitor
    Serial.println("Robojax Tutorial");
    Serial.println("ACS712 Current Sensor");
}

void loop() {

  //Robojax.com ACS712 Current Sensor 
  float voltage_raw =   (5.0 / 1023.0)* analogRead(VIN);// Read the voltage from sensor
  voltage =  voltage_raw - QOV + 0.012 ;// 0.000 is a value to make voltage zero when there is no current
  float current = voltage / sensitivity[model];
 
  if(abs(current) > cutOffLimit ){
    Serial.print("V: ");
    Serial.print(voltage,3);// print voltage with 3 decimal places
    Serial.print("V, I: ");
    Serial.print(current,2); // print the current with 2 decimal places
    Serial.println("A");
  }else{
    Serial.println("No Current");
  }
  delay(500);
}
```

## 11/30/2021: Fixes and Current Sensor Calibration
**Objectives:** The goal of today was to add another aspect of our monitoring subsystem. With most of the I2C communication from the ESP32 working with the exception of the ADC isolator, we want to implement our current sensor to ensure that it works and measures current as expected. The voltage divider and sensing is also something that we want to complete. With the temperature sensor working as expected and the complete addition of voltage and current sensor, most of our monitoring subsystem is complete.

**Outcome:** We first tested out the current sensor on a breadboard and we read the base output voltage when there was no current flowing through it. This output voltage was simply the imput voltage, in this case 5V, divided by 2 so we observed a 2.5V output. Since we attached a load to the input of the current sensor, we were reading very minimal values of the current and it was extremely difficult to observe a change in the output voltage or to see whether the current was being affected. Due to the sensitivity being 100mV/A, having about 0.02 Amps flowing through the load only gives a change of around 20mV. 
To resolve this issue, we simply disconnected the load and sometimes the DC supply would not output a current even when it was set, the solution to this was to ensure that the voltage output was outputting a voltage along with it as well. With the Keithley DC supply, we were able to a supply a max of around 5A due to the limitations of the supply that we used but we were observing around a 500mV increase from our base value of 2.5V when we fed 5A through it. Although there were some differences in the each of the current sensors reference value and discrepencies within the voltage with varied as we went to high levels of current, we resolved this by going through the values and calibrating both the voltage and current manually. 

* Process for Calibrating the Voltage:


* Process for Calibrating the Current:


## 12/01/2021: Culmination of the Monitoring Subsystem
**Objectives:** As all the components to measure the solar panel parameters were realized the day before, we wanted to implement them and add them onto the PCB to observe measurements onto the OLED. Another finalized section of the monitoring subsystem that we had to complete was the switching configurations with the darlington array along with the relays. 

**Outcome:** When we added all the components onto our PCB board, we noticed that the voltage sensing was not updating and required some fixing before before we could work on the relays. It took us a while to figure out and we were following traces, backtracking to points when the voltage sensing was working on its own. The issue was that since we were not implementing the ADC isolator and that the voltage is sent through I2C from through the SDA and SCL pins to the EPS32 microcontroller, the separate ground planes were affecting our ability to take measurements. To resolve this, we soldered one of the ESP32 grounds to the NEG_Output pin where we attach to the voltage divider and our voltage sensing was working again. The current sensor works as expected as well and the thermocouples were updating temperature especially when we added contact heat to it, we saw that value increase. 
The darlington array we were having some issues with because we were sending the appropriate signals but the relays were in fact closing but not for the appropriate configurations. Since the darlington array was already testing with the relays on a breadboard, we know that the code works and we needed to map out the control signals appropriately from the ESP32 to the darlington. We were measuring the output of the ESP32 pins that were toggled high and they outputted around 12 volts whilst the output of the darlington varied from 1V, 4V, to 11V which was unusual. We soldered a darlington array on the breakout board to test them on the breadboard again to see if we could figure out the issue but everything was working fine on the the breaedboard. We hope to resolve and figure out this issue because for the sake of configuring the solar panels, it is an important aspect of our monitoring subsystem.
We were also able to meet with Kevin today and he was able to help us set up the solar panels on the roof so that we could observe and monitor voltage, current, and temperature readings from the solar panels. Since the solar panels on the roof already have an Attabox mounted with a board solely responsible for manually switching the solar cell configuration,  we would have to go out on the roof to change from 32, to 64, to 128-cell configurations. Therefore, we only operated on 32-cells to test our measurements. Since there was very little to no sun by the time we were able to set up, we planned on coming in the next morning to utilize and measure parameters of the actual solar panels. 
We were able to utilize another small solar panel which outputs around 9V and 4A of current at our workstation and we were able to shine a lamp on it and extract power from there as a substitute at the moment. We were able to pull voltage, current, and temperature readings from there as well as having it update and send POST requests to the website. 

## 12/02/2021: Final Demo Presentation
**Objectives:** Demonstrate our final version of our project and display all the different requirements and verifications that we were able to achieve. Explain what worked and what didn't work with reasons as to why some parts did not work and to also explain future improvements and work that we can possibly implement to further improve our design.

**Outcome:** Today, we demo'd our project to Professor Schuh, Evan, and another TA. We did our best to explain how the different subsystems worked in conjunction with one another and also go through different verifications of the most important parts of the project worked. This included the relay switching between different configurations, the monitoring subsystem (although for some reason the thermocouples worked a couple hours prior to the demo, it was not displaying the correct temperature at the time we demo'd - working to figure out and explain why there is inconsistency), the microcontroller subsystem, and the website that Nikhil created. He was able to show how POST data was being received and updated and we explained the issues that we had during the build of our project. Overall, I believe there are many more improvements that could be done and we hope that this project will be a stepping stone for another group should they decide to build upon our work.
