NikhilMSeb/ECE445-FA21-Solar/notebooks/msafi2/old pcb designs/README

Old PCB design files on Kicad
Final Board design can be found in Board folder in main fork.
