NikhilMSeb/ECE445-FA21-Solar/team documents/Final Board/Final_Project.kicad_pcb

## KiCad design team documents/Final Board/Final_Project.kicad_pcb (2021-11-30)

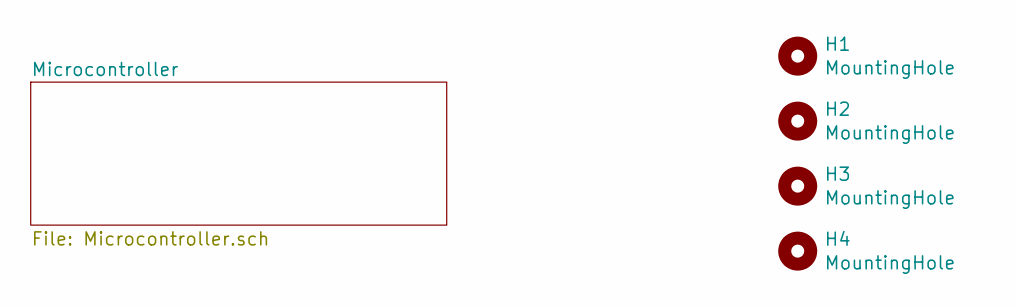
[picture p9: schematic Final_Project.sch]

Parts:
H1, H2, H3, H4: MountingHole; MountingHole_3.2mm_M3

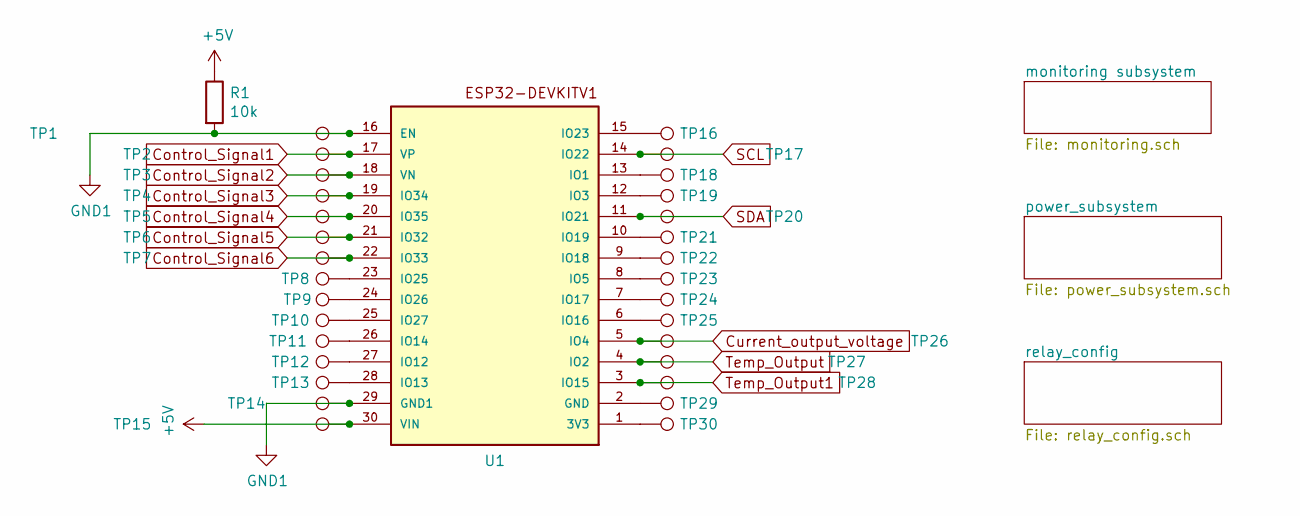
[picture p10: schematic Microcontroller.sch]

Parts:
R1: 10k; R_0603_1608Metric_Pad0.98x0.95mm_HandSolder
TP1, TP2, TP3, TP4, TP5, TP6, TP7, TP8, TP9, TP10, TP11, TP12, TP13, TP14, TP15, TP16, TP17, TP18, TP19, TP20, TP21, TP22, TP23, TP24, TP25, TP26, TP27, TP28, TP29, TP30: TestPoint; PinHeader_1x01_P2.54mm_Vertical
U1: ESP32DEVKITV1; ESP32-DEVKITV1

Connections:
+5V: R1.1, TP15.1, U1.30 (VIN); also elsewhere on the board
Control_Signal1: TP2.1, U1.17 (VP); also elsewhere on the board
Control_Signal2: TP3.1, U1.18 (VN); also elsewhere on the board
Control_Signal3: TP4.1, U1.19 (IO34); also elsewhere on the board
Control_Signal4: TP5.1, U1.20 (IO35); also elsewhere on the board
Control_Signal5: TP6.1, U1.21 (IO32); also elsewhere on the board
Control_Signal6: TP7.1, U1.22 (IO33); also elsewhere on the board
Current_output_voltage: TP26.1, U1.5 (IO4); also elsewhere on the board
GND1: R1.2, TP1.1, TP14.1, U1.16 (EN), U1.29 (GND1); also elsewhere on the board
unnamed: TP8.1, U1.23 (IO25)
unnamed: TP9.1, U1.24 (IO26)
unnamed: TP10.1, U1.25 (IO27)
unnamed: TP11.1, U1.26 (IO14)
unnamed: TP12.1, U1.27 (IO12)
unnamed: TP13.1, U1.28 (IO13)
unnamed: TP16.1, U1.15 (IO23)
unnamed: TP18.1, U1.13 (IO1)
unnamed: TP19.1, U1.12 (IO3)
unnamed: TP21.1, U1.10 (IO19)
unnamed: TP22.1, U1.9 (IO18)
unnamed: TP23.1, U1.8 (IO5)
unnamed: TP24.1, U1.7 (IO17)
unnamed: TP25.1, U1.6 (IO16)
unnamed: TP29.1, U1.2 (GND)
unnamed: TP30.1, U1.1 (3V3)
SCL: TP17.1, U1.14 (IO22); also elsewhere on the board
SDA: TP20.1, U1.11 (IO21); also elsewhere on the board
Temp_Output: TP27.1, U1.4 (IO2); also elsewhere on the board
Temp_Output1: TP28.1, U1.3 (IO15); also elsewhere on the board

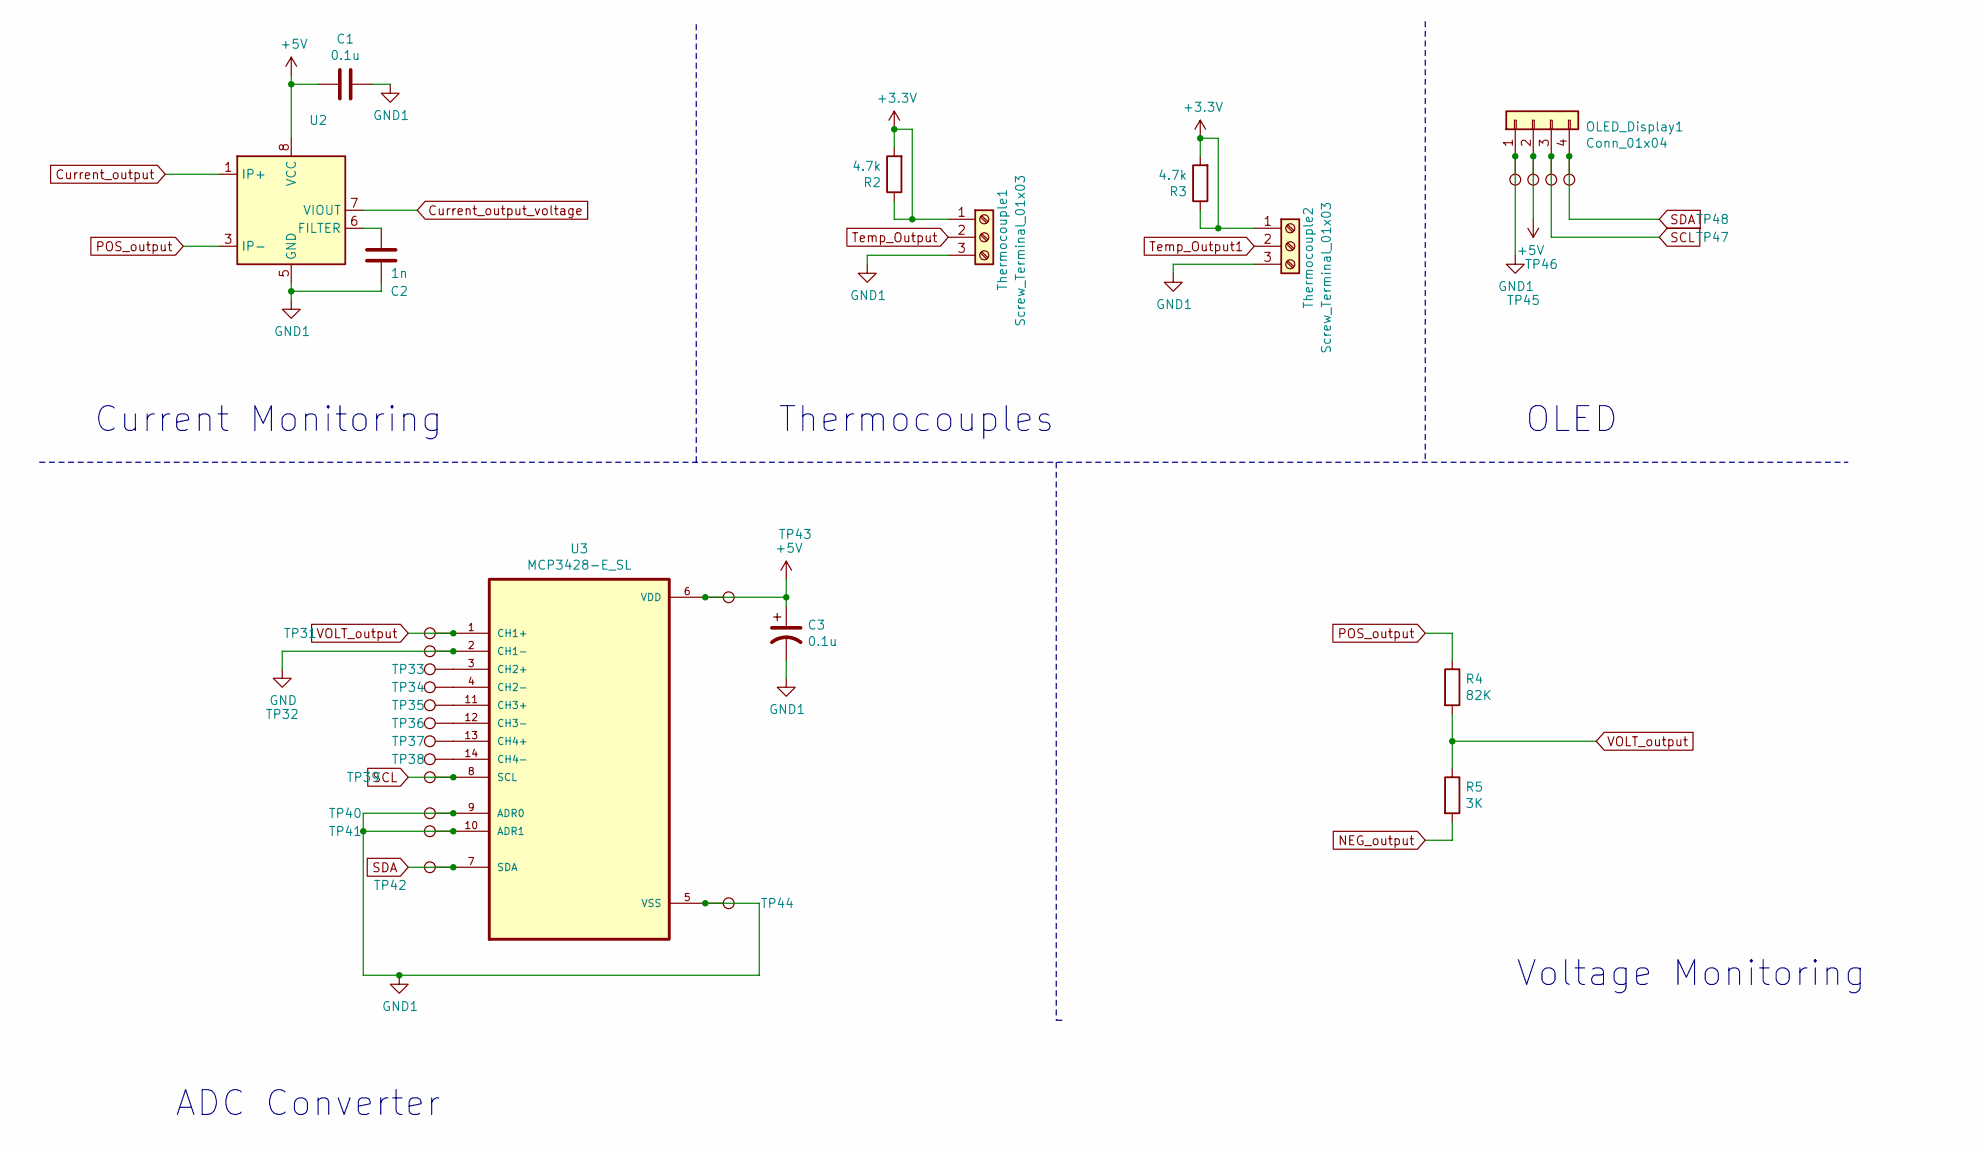
[picture p11: schematic monitoring.sch]

Parts:
C1, C3: 0.1u; C_0805_2012Metric_Pad1.18x1.45mm_HandSolder
C2: 1n; C_0805_2012Metric_Pad1.18x1.45mm_HandSolder
OLED_Display1: Conn_01x04; OLEDdisplay
R2, R3: 4.7k; R_0603_1608Metric_Pad0.98x0.95mm_HandSolder
R4: 82K; R_0603_1608Metric_Pad0.98x0.95mm_HandSolder
R5: 3K; R_0603_1608Metric_Pad0.98x0.95mm_HandSolder
TP31, TP32, TP33, TP34, TP35, TP36, TP37, TP38, TP39, TP40, TP41, TP42, TP43, TP44, TP45, TP46, TP47, TP48: TestPoint; PinHeader_1x01_P2.54mm_Vertical
Thermocouple1, Thermocouple2: Screw_Terminal_01x03; 2828373
U2: ACS714xLCTR-30A; SOIC127P600X175-8N
U3: MCP3428-E_SL; SOIC127P600X175-14N

Connections:
+3V3: R2.1, R2.2, R3.1, R3.2, Thermocouple1.1, Thermocouple2.1; also elsewhere on the board
+5V: C1.2, C3.1, OLED_Display1.2, TP43.1, TP46.1, U2.8 (VCC), U3.6 (VDD); also elsewhere on the board
Current_output: U2.1 (IP+), U2.2 (IP+); also elsewhere on the board
Current_output_voltage: U2.7 (VIOUT); also elsewhere on the board
GND: TP32.1, U3.2 (CH1-)
GND1: C1.1, C2.1, C3.2, OLED_Display1.1, TP40.1, TP41.1, TP44.1, TP45.1, Thermocouple1.3, Thermocouple2.3, U2.5 (GND), U3.5 (VSS), U3.9 (ADR0), U3.10 (ADR1); also elsewhere on the board
NEG_output: R5.2; also elsewhere on the board
unnamed: C2.2, U2.6 (FILTER)
unnamed: TP33.1, U3.3 (CH2+)
unnamed: TP34.1, U3.4 (CH2-)
unnamed: TP35.1, U3.11 (CH3+)
unnamed: TP36.1, U3.12 (CH3-)
unnamed: TP37.1, U3.13 (CH4+)
unnamed: TP38.1, U3.14 (CH4-)
POS_output: R4.1, U2.3 (IP-), U2.4 (IP-); also elsewhere on the board
SCL: OLED_Display1.3, TP39.1, TP47.1, U3.8 (SCL); also elsewhere on the board
SDA: OLED_Display1.4, TP42.1, TP48.1, U3.7 (SDA); also elsewhere on the board
Temp_Output: Thermocouple1.2; also elsewhere on the board
Temp_Output1: Thermocouple2.2; also elsewhere on the board
VOLT_output: R4.2, R5.1, TP31.1, U3.1 (CH1+)

Notes on the sheet:
Current Monitoring
Thermocouples
OLED
ADC Converter
Voltage Monitoring

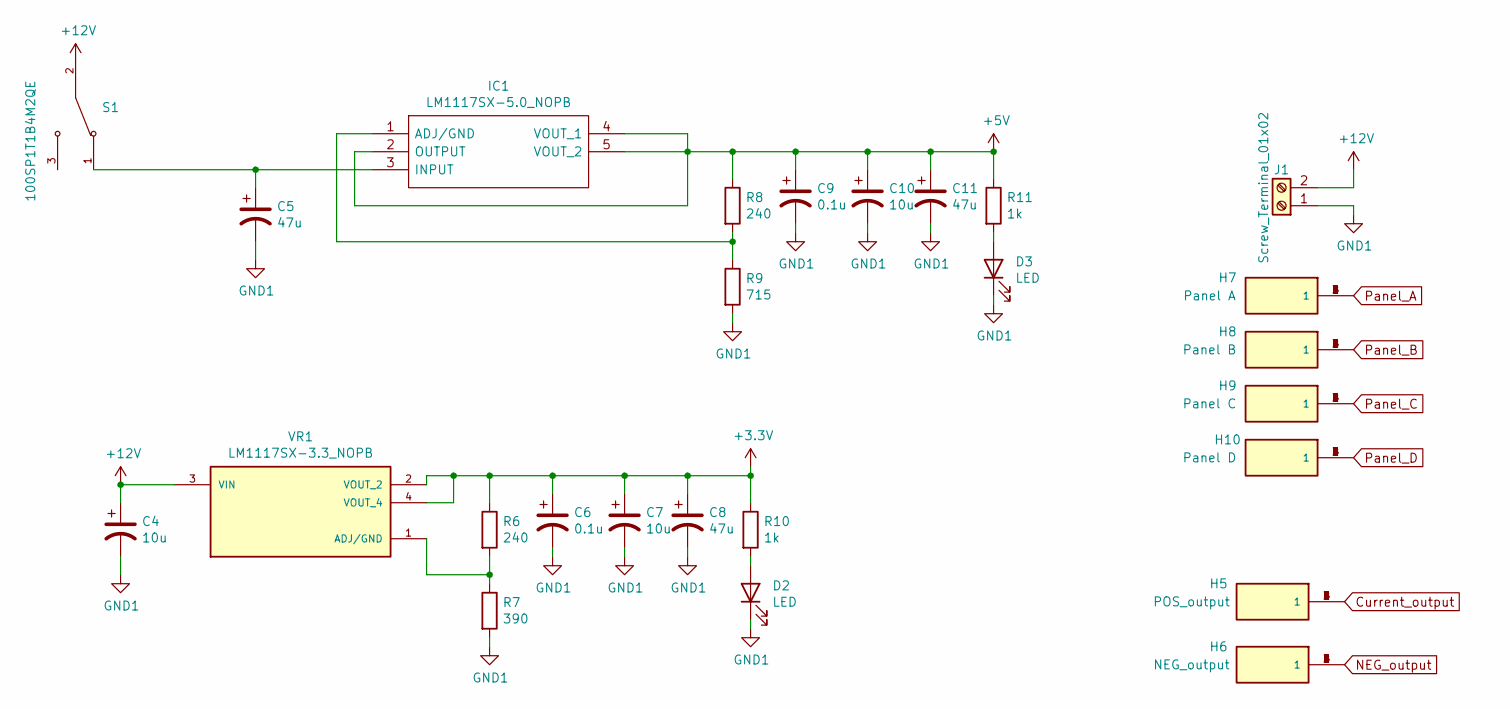
[picture p12: schematic power_subsystem.sch]

Parts:
C4, C7, C10: 10u; C_0805_2012Metric_Pad1.18x1.45mm_HandSolder
C5, C8, C11: 47u; CP_Elec_6.3x5.8
C6, C9: 0.1u; C_0805_2012Metric_Pad1.18x1.45mm_HandSolder
D2, D3: LED; D_0603_1608Metric_Pad1.05x0.95mm_HandSolder
H5: POS_output; KEYSTONE_8197; PARTREV C
H6: NEG_output; KEYSTONE_8197; PARTREV C
H7: Panel A; KEYSTONE_8197; PARTREV C
H8: Panel B; KEYSTONE_8197; PARTREV C
H9: Panel C; KEYSTONE_8197; PARTREV C
H10: Panel D; KEYSTONE_8197; PARTREV C
IC1: LM1117SX-5.0_NOPB; LM1117SX50NOPB; Manufacturer_Part_Number LM1117SX-5.0/NOPB; Mouser Part Number 926-LM1117SX50NOPB
J1: Screw_Terminal_01x02; 2828372
R6, R8: 240; R_0603_1608Metric_Pad0.98x0.95mm_HandSolder
R7: 390; R_0603_1608Metric_Pad0.98x0.95mm_HandSolder
R9: 715; R_0603_1608Metric_Pad0.98x0.95mm_HandSolder
R10, R11: 1k; R_0603_1608Metric_Pad0.98x0.95mm_HandSolder
S1: 100SP1T1B4M2QE; SW_100SP1T1B4M2QE; PARTREV E
VR1: LM1117SX-3.3_NOPB; TO254P1435X464-4N; PARTREV O

Connections:
+3V3: C6.1, C7.1, C8.1, R6.1, R10.1, VR1.2 (VOUT_2), VR1.4 (VOUT_4); also elsewhere on the board
+5V: C9.1, C10.1, C11.1, IC1.2 (OUTPUT), IC1.4 (VOUT_1), IC1.5 (VOUT_2), R8.1, R11.1; also elsewhere on the board
+12V: C4.1, J1.2, S1.2, VR1.3 (VIN); also elsewhere on the board
Current_output: H5.1, H5.2, H5.3, H5.4, H5.5, H5.6; also elsewhere on the board
GND1: C4.2, C5.2, C6.2, C7.2, C8.2, C9.2, C10.2, C11.2, D2.1 (K), D3.1 (K), J1.1, R7.2, R9.2; also elsewhere on the board
NEG_output: H6.1, H6.2, H6.3, H6.4, H6.5, H6.6; also elsewhere on the board
unnamed: D2.2 (A), R10.2
unnamed: D3.2 (A), R11.2
unnamed: IC1.1 (ADJ/GND), R8.2, R9.1
unnamed: R6.2, R7.1, VR1.1 (ADJ/GND)
Panel_A: H7.1, H7.2, H7.3, H7.4, H7.5, H7.6; also elsewhere on the board
Panel_B: H8.1, H8.2, H8.3, H8.4, H8.5, H8.6; also elsewhere on the board
Panel_C: H9.1, H9.2, H9.3, H9.4, H9.5, H9.6; also elsewhere on the board
Panel_D: H10.1, H10.2, H10.3, H10.4, H10.5, H10.6; also elsewhere on the board

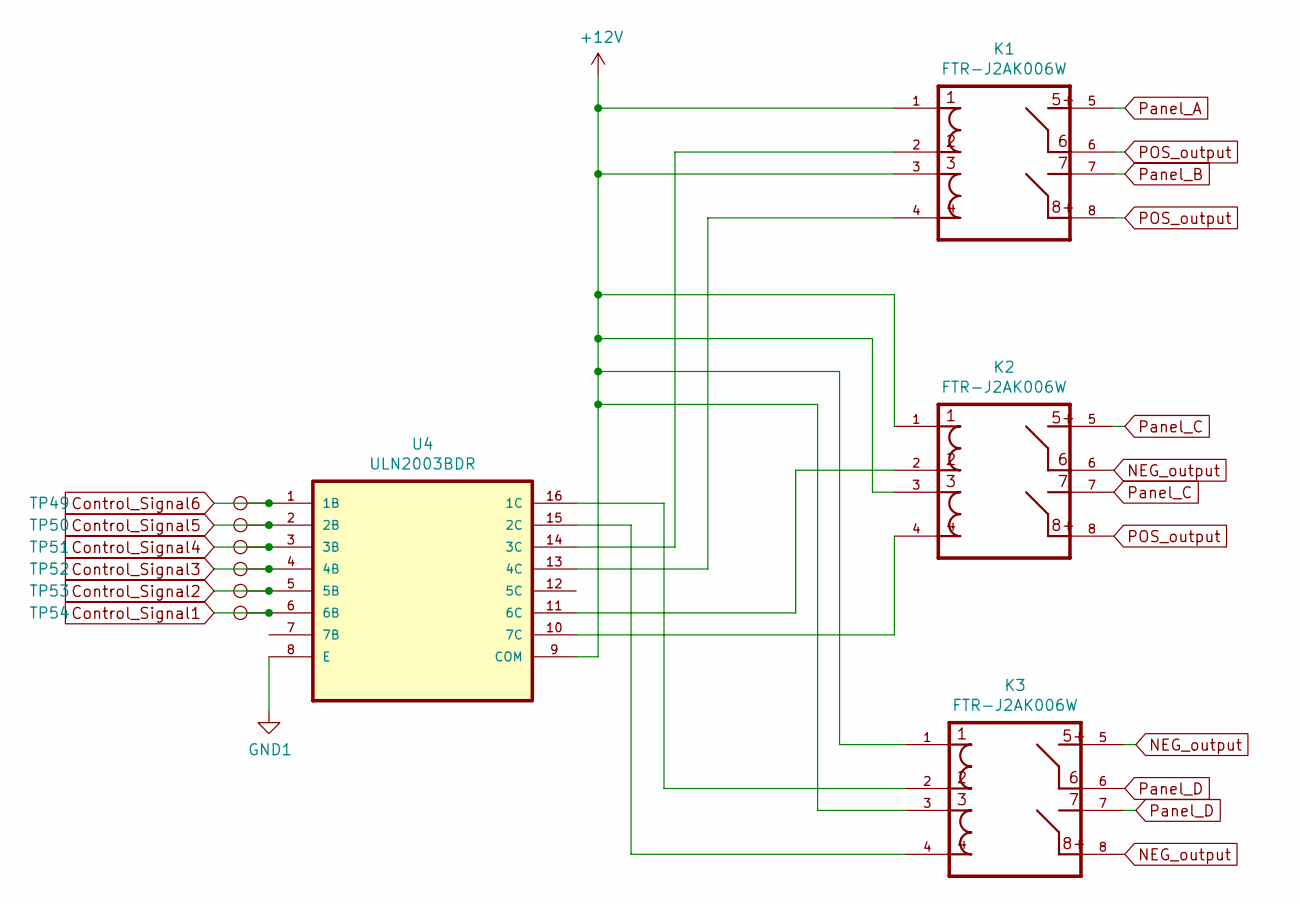
[picture p13: schematic relay_config.sch]

Parts:
K1, K2, K3: FTR-J2AK006W; RELAY_FTR-J2AK006W
TP49, TP50, TP51, TP52, TP53, TP54: TestPoint; PinSocket_1x01_P2.54mm_Vertical
U4: ULN2003BDR; SOIC127P600X175-16N

Connections:
+12V: K1.1, K1.3, K2.1, K2.3, K3.1, K3.3, U4.9 (COM); also elsewhere on the board
Control_Signal1: TP54.1, U4.6 (6B); also elsewhere on the board
Control_Signal2: TP53.1, U4.5 (5B); also elsewhere on the board
Control_Signal3: TP52.1, U4.4 (4B); also elsewhere on the board
Control_Signal4: TP51.1, U4.3 (3B); also elsewhere on the board
Control_Signal5: TP50.1, U4.2 (2B); also elsewhere on the board
Control_Signal6: TP49.1, U4.1 (1B); also elsewhere on the board
GND1: U4.8 (E); also elsewhere on the board
NEG_output: K2.6, K3.5, K3.8; also elsewhere on the board
unnamed: K1.2, U4.14 (3C)
unnamed: K1.4, U4.13 (4C)
unnamed: K2.2, U4.11 (6C)
unnamed: K2.4, U4.10 (7C)
unnamed: K3.2, U4.16 (1C)
unnamed: K3.4, U4.15 (2C)
POS_output: K1.6, K1.8, K2.8; also elsewhere on the board
Panel_A: K1.5; also elsewhere on the board
Panel_B: K1.7; also elsewhere on the board
Panel_C: K2.5, K2.7; also elsewhere on the board
Panel_D: K3.6, K3.7; also elsewhere on the board

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
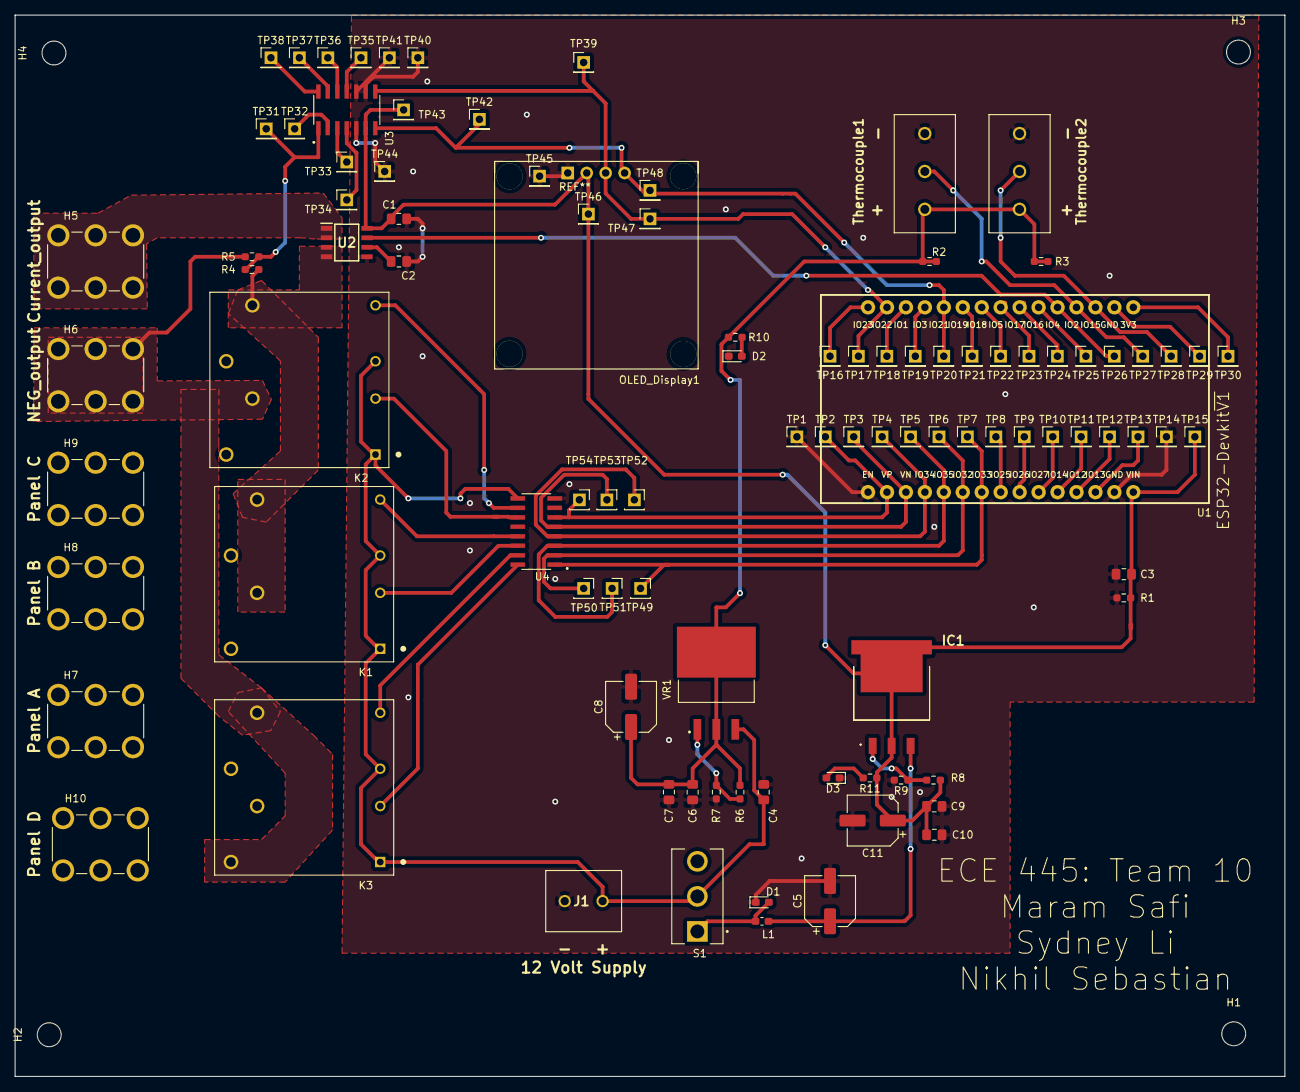
[picture p14: board team documents/Final Board/Final_Project.kicad_pcb from above]

Board: 2 copper layers, 170.2 x 142.2 mm, 104 parts (0 on the bottom side), 59 nets.

Other parts of the board:
D1: D; D_0603_1608Metric_Pad1.05x0.95mm_HandSolder
L1: 100u; L_0603_1608Metric_Pad1.05x0.95mm_HandSolder

Their connections:
GND1: D1.1; also elsewhere on the board
