NikhilMSeb/ECE445-FA21-Solar/notebooks/msafi2/old pcb designs/old board versions/Final_Project.kicad_pcb

## KiCad design notebooks/msafi2/old pcb designs/old board versions/Final_Project.kicad_pcb (2021-11-16, an earlier design)


Parts:
H1, H2, H3, H4: MountingHole; MountingHole_3.2mm_M3

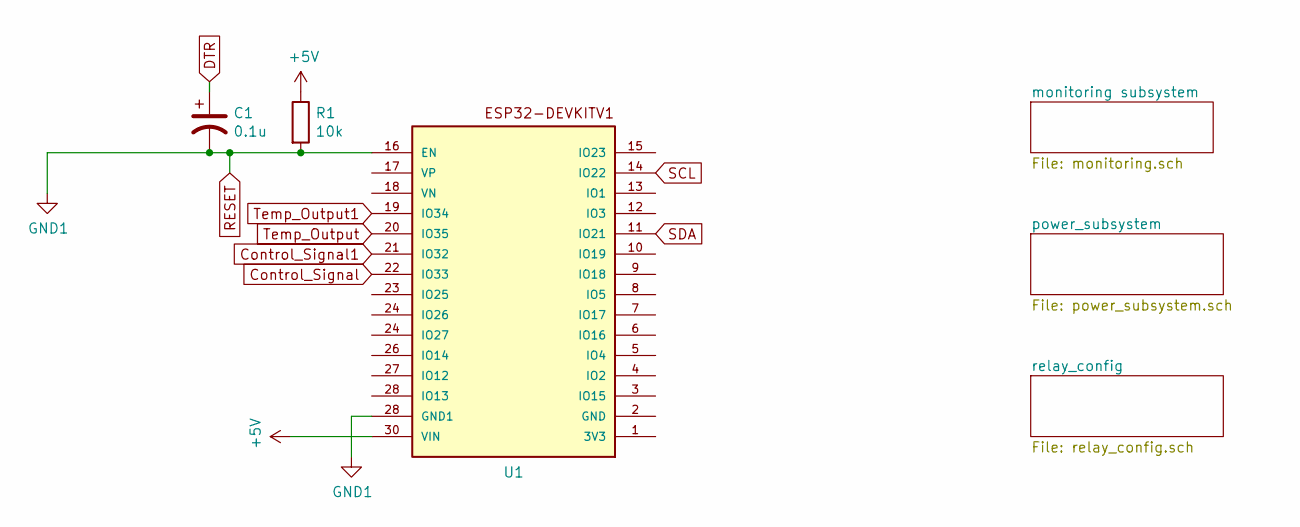
[picture p15: schematic Microcontroller.sch]

Parts:
C1: 0.1u; C_0805_2012Metric_Pad1.18x1.45mm_HandSolder
R1: 10k; R_0603_1608Metric_Pad0.98x0.95mm_HandSolder
U1: ESP32DEVKITV1; ESP32-DEVKITV1

Connections:
+5V: R1.1, U1.30 (VIN); also elsewhere on the board
Control_Signal: U1.22 (IO33); also elsewhere on the board
Control_Signal1: U1.21 (IO32); also elsewhere on the board
DTR: C1.1
RESET: C1.2, R1.2, U1.16 (EN), U1.28 (GND1)
SCL: U1.14 (IO22); also elsewhere on the board
SDA: U1.11 (IO21); also elsewhere on the board
Temp_Output: U1.20 (IO35); also elsewhere on the board
Temp_Output1: U1.19 (IO34)

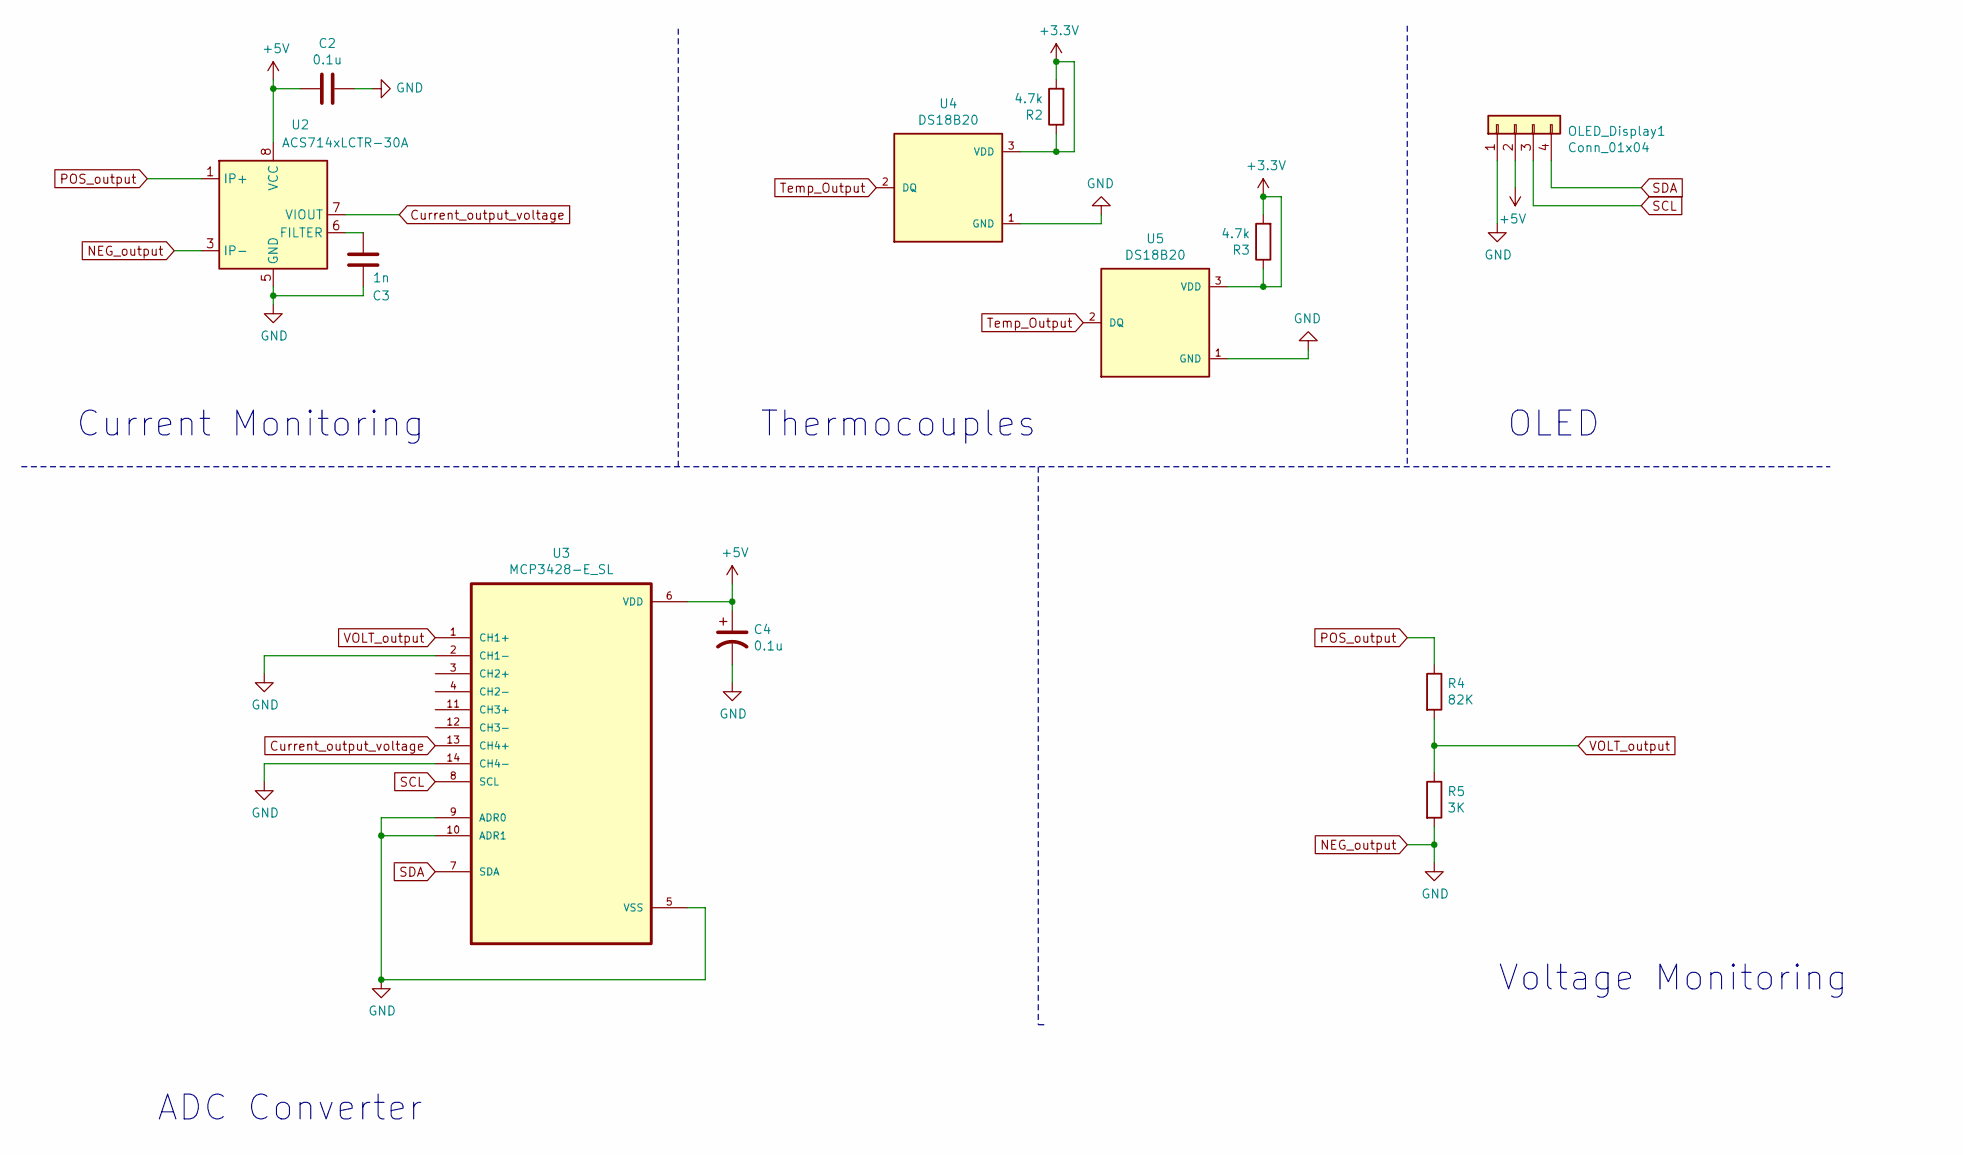
[picture p16: schematic monitoring.sch]

Parts:
C2, C4: 0.1u; C_0805_2012Metric_Pad1.18x1.45mm_HandSolder
C3: 1n; C_0805_2012Metric_Pad1.18x1.45mm_HandSolder
OLED_Display1: Conn_01x04; PinHeader_1x04_P2.54mm_Vertical
R2, R3: 4.7k; R_0603_1608Metric_Pad0.98x0.95mm_HandSolder
R4: 82K; R_0603_1608Metric_Pad0.98x0.95mm_HandSolder
R5: 3K; R_0603_1608Metric_Pad0.98x0.95mm_HandSolder
U2: ACS714xLCTR-30A; SOIC-8_3.9x4.9mm_P1.27mm
U3: MCP3428-E_SL; SOIC127P600X175-14N
U4, U5: DS18B20; TO-92-TO92127P495H2044-3; PARTREV 5

Connections:
+3V3: R2.1, R2.2, R3.1, R3.2, U4.3 (VDD), U5.3 (VDD); also elsewhere on the board
+5V: C2.2, C4.1, OLED_Display1.2, U2.8 (VCC), U3.6 (VDD); also elsewhere on the board
Current_output_voltage: U2.7 (VIOUT), U3.13 (CH4+)
NEG_output: C2.1, C3.1, C4.2, OLED_Display1.1, R5.2, U2.3 (IP-), U2.4 (IP-), U2.5 (GND), U3.2 (CH1-), U3.5 (VSS), U3.9 (ADR0), U3.10 (ADR1), U3.14 (CH4-), U4.1 (GND), U5.1 (GND); also elsewhere on the board
unnamed: C3.2, U2.6 (FILTER)
POS_output: R4.1, U2.1 (IP+), U2.2 (IP+); also elsewhere on the board
SCL: OLED_Display1.3, U3.8 (SCL); also elsewhere on the board
SDA: OLED_Display1.4, U3.7 (SDA); also elsewhere on the board
Temp_Output: U4.2 (DQ), U5.2 (DQ); also elsewhere on the board
VOLT_output: R4.2, R5.1, U3.1 (CH1+)

Notes on the sheet:
Current Monitoring
Thermocouples
OLED
ADC Converter
Voltage Monitoring

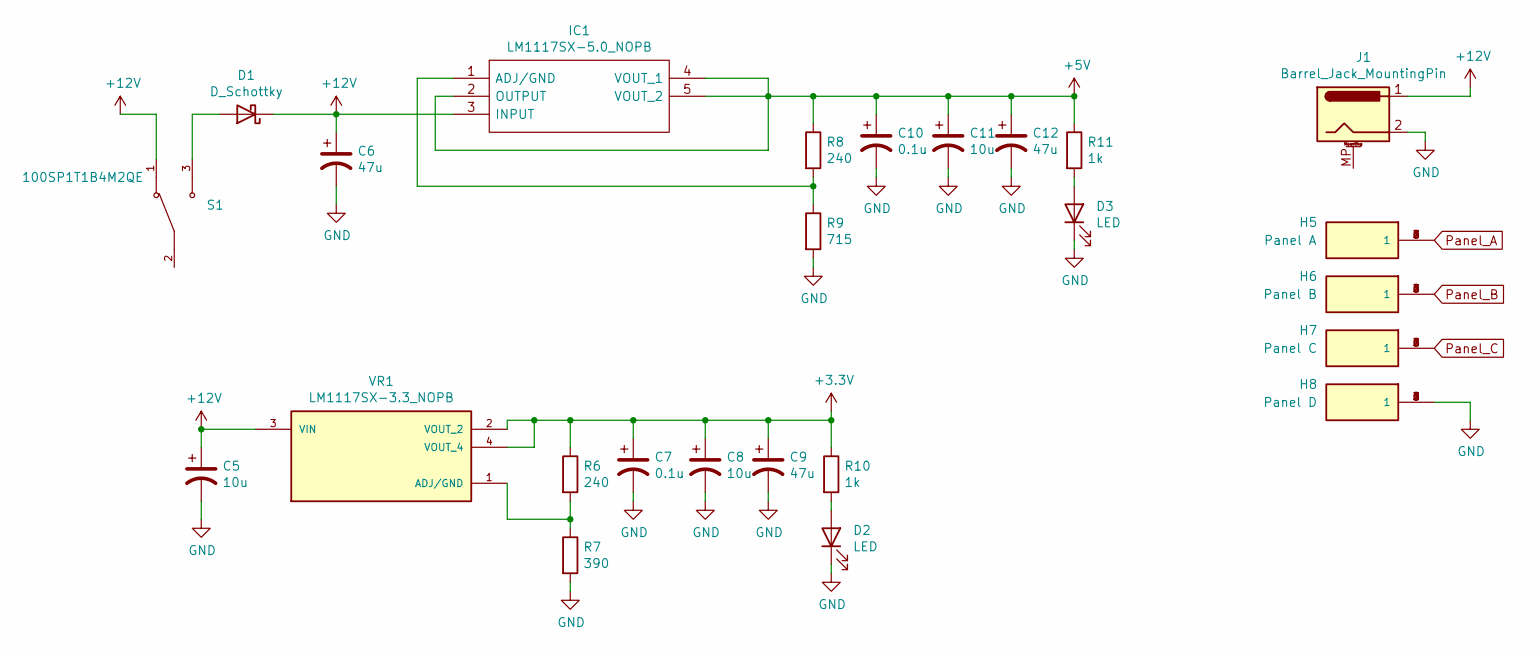
[picture p17: schematic power_subsystem.sch]

Parts:
C5, C8, C11: 10u; C_0805_2012Metric_Pad1.18x1.45mm_HandSolder
C6, C9, C12: 47u; CP_Elec_6.3x5.8
C7, C10: 0.1u; C_0805_2012Metric_Pad1.18x1.45mm_HandSolder
D1: D_Schottky; DIOM5226X240N
D2, D3: LED; D_0603_1608Metric_Pad1.05x0.95mm_HandSolder
H5: Panel A; KEYSTONE_8197; PARTREV C
H6: Panel B; KEYSTONE_8197; PARTREV C
H7: Panel C; KEYSTONE_8197; PARTREV C
H8: Panel D; KEYSTONE_8197; PARTREV C
IC1: LM1117SX-5.0_NOPB; LM1117SX50NOPB; Manufacturer_Part_Number LM1117SX-5.0/NOPB; Mouser Part Number 926-LM1117SX50NOPB
J1: Barrel_Jack_MountingPin; BarrelJack_Wuerth_6941xx301002
R6, R8: 240; R_0603_1608Metric_Pad0.98x0.95mm_HandSolder
R7: 390; R_0603_1608Metric_Pad0.98x0.95mm_HandSolder
R9: 715; R_0603_1608Metric_Pad0.98x0.95mm_HandSolder
R10, R11: 1k; R_0603_1608Metric_Pad0.98x0.95mm_HandSolder
S1: 100SP1T1B4M2QE; SW_100SP1T1B4M2QE; PARTREV E
VR1: LM1117SX-3.3_NOPB; TO254P1435X464-4N; PARTREV O

Connections:
+3V3: C7.1, C8.1, C9.1, R6.1, R10.1, VR1.2 (VOUT_2), VR1.4 (VOUT_4); also elsewhere on the board
+5V: C10.1, C11.1, C12.1, IC1.2 (OUTPUT), IC1.4 (VOUT_1), IC1.5 (VOUT_2), R8.1, R11.1; also elsewhere on the board
+12V: C5.1, C6.1, D1.1 (K), IC1.3 (INPUT), J1.1, S1.1, VR1.3 (VIN); also elsewhere on the board
NEG_output: C5.2, C6.2, C7.2, C8.2, C9.2, C10.2, C11.2, C12.2, D2.1 (K), D3.1 (K), H8.1, H8.2, H8.3, H8.4, H8.5, H8.6, J1.2, R7.2, R9.2; also elsewhere on the board
unnamed: D1.2 (A), S1.3
unnamed: D2.2 (A), R10.2
unnamed: D3.2 (A), R11.2
unnamed: IC1.1 (ADJ/GND), R8.2, R9.1
unnamed: R6.2, R7.1, VR1.1 (ADJ/GND)
Panel_A: H5.1, H5.2, H5.3, H5.4, H5.5, H5.6; also elsewhere on the board
Panel_B: H6.1, H6.2, H6.3, H6.4, H6.5, H6.6; also elsewhere on the board
Panel_C: H7.1, H7.2, H7.3, H7.4, H7.5, H7.6; also elsewhere on the board

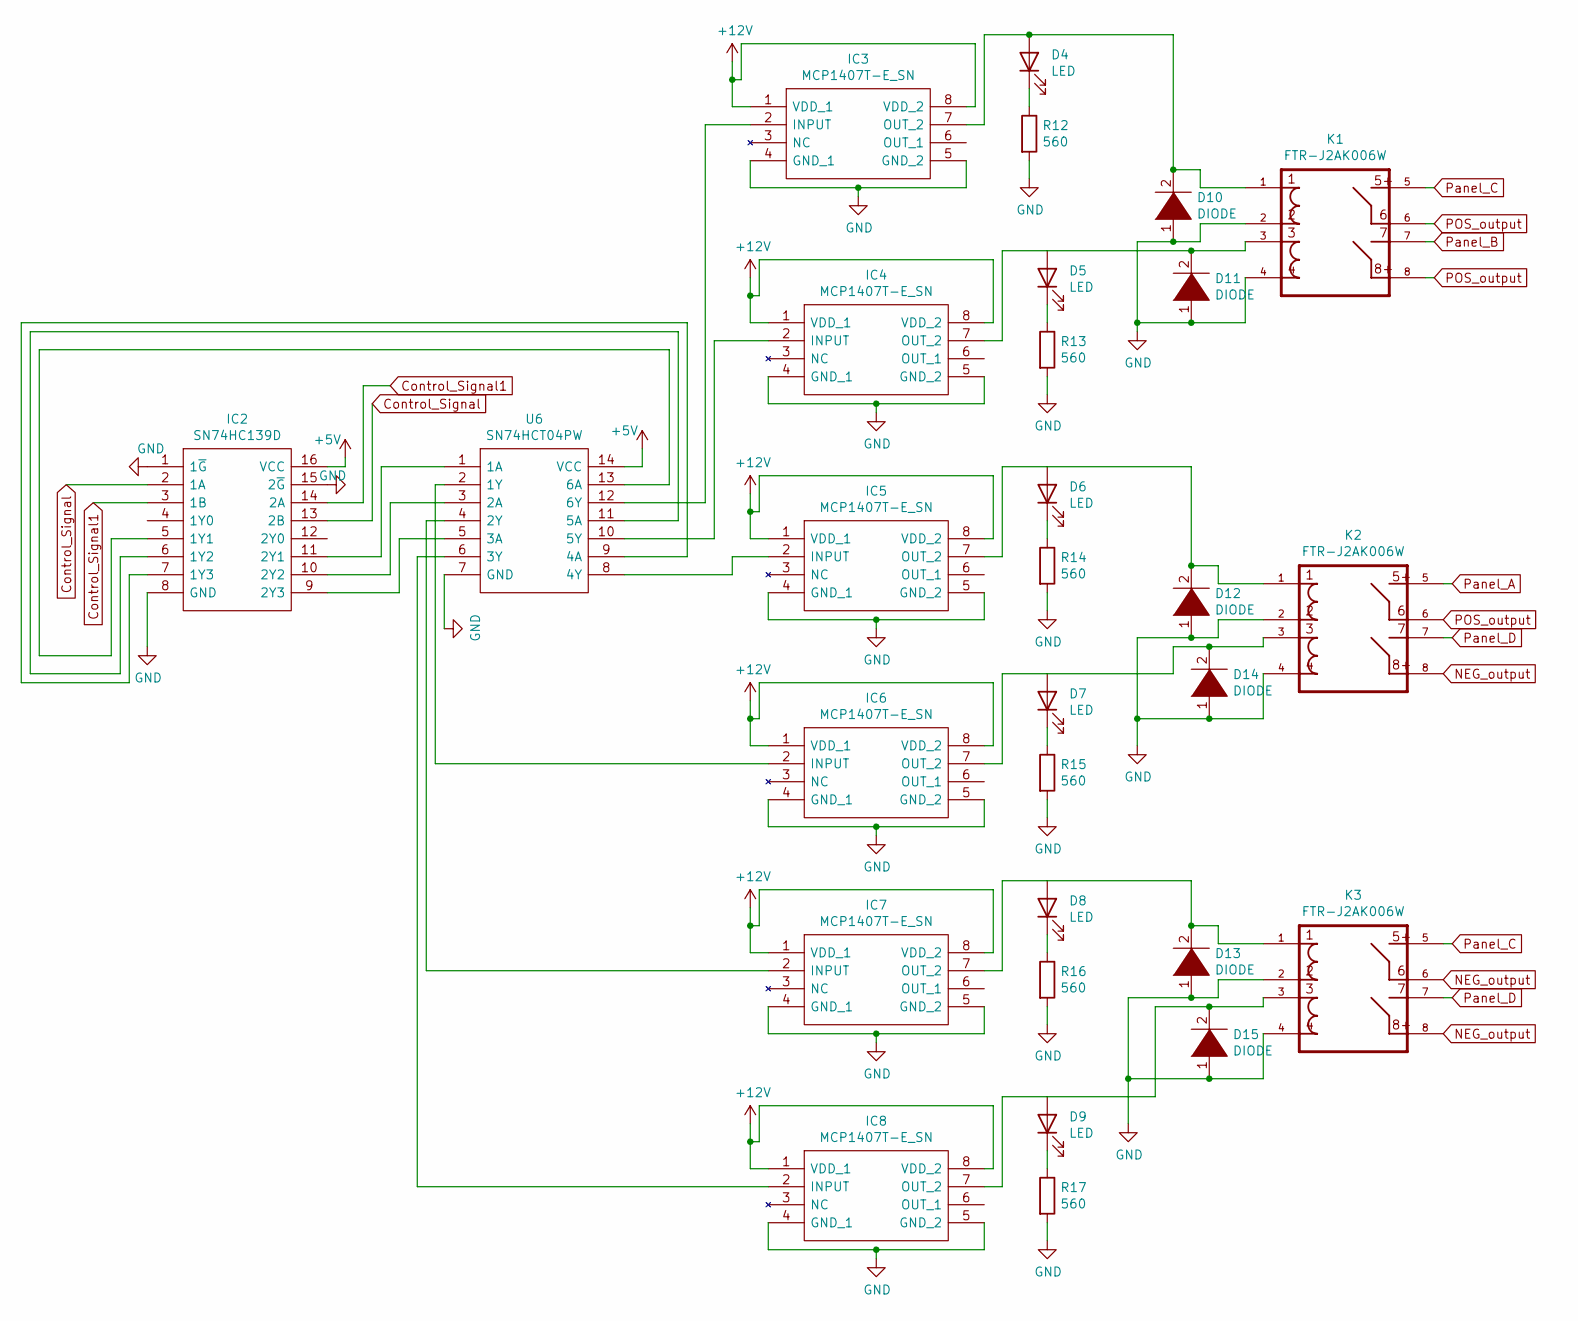
[picture p18: schematic relay_config.sch]

Parts:
D4, D5, D6, D7, D8, D9: LED; D_0603_1608Metric_Pad1.05x0.95mm_HandSolder
D10, D11, D12, D13, D14, D15: DIODE; DPAK228P987X240-3N
IC2: SN74HC139D; SOIC127P600X175-16N; Mouser Part Number 595-SN74HC139D
IC3, IC4, IC5, IC6, IC7, IC8: MCP1407T-E_SN; SOIC127P600X175-8N; Manufacturer_Part_Number MCP1407T-E/SN; Mouser Part Number 579-MCP1407T-E/SN
K1, K2, K3: FTR-J2AK006W; RELAY_FTR-J2AK006W
R12, R13, R14, R15, R16, R17: 560; R_0603_1608Metric_Pad0.98x0.95mm_HandSolder
U6: SN74HCT04PW; DIP-14_W7.62mm_Socket_LongPads; Manufacturer_Part_Number SN74HCT04PW; Mouser Part Number 595-SN74HCT04PW

Connections:
+5V: IC2.16 (VCC), U6.14 (VCC); also elsewhere on the board
+12V: IC3.1 (VDD_1), IC3.8 (VDD_2), IC4.1 (VDD_1), IC4.8 (VDD_2), IC5.1 (VDD_1), IC5.8 (VDD_2), IC6.1 (VDD_1), IC6.8 (VDD_2), IC7.1 (VDD_1), IC7.8 (VDD_2), IC8.1 (VDD_1), IC8.8 (VDD_2); also elsewhere on the board
Control_Signal: IC2.2 (1A), IC2.13 (2B); also elsewhere on the board
Control_Signal1: IC2.3 (1B), IC2.14 (2A); also elsewhere on the board
NEG_output: D10.1 (K), D11.1 (K), D12.1 (K), D13.1 (K), D14.1 (K), D15.1 (K), IC2.1 (1~G), IC2.8 (GND), IC2.15 (2~G), IC3.4 (GND_1), IC3.5 (GND_2), IC4.4 (GND_1), IC4.5 (GND_2), IC5.4 (GND_1), IC5.5 (GND_2), IC6.4 (GND_1), IC6.5 (GND_2), IC7.4 (GND_1), IC7.5 (GND_2), IC8.4 (GND_1), IC8.5 (GND_2), K1.2, K1.4, K2.2, K2.4, K2.8, K3.2, K3.4, K3.6, K3.8, R12.2, R13.2, R14.2, R15.2, R16.2, R17.2, U6.7 (GND); also elsewhere on the board
unnamed: D4.1 (K), R12.1
unnamed: D5.1 (K), R13.1
unnamed: D6.1 (K), R14.1
unnamed: D7.1 (K), R15.1
unnamed: D8.1 (K), R16.1
unnamed: D9.1 (K), R17.1
unnamed: D4.2 (A), D10.2 (A), IC3.7 (OUT_2), K1.1
unnamed: D5.2 (A), D11.2 (A), IC4.7 (OUT_2), K1.3
unnamed: D6.2 (A), D12.2 (A), IC5.7 (OUT_2), K2.1
unnamed: D8.2 (A), D13.2 (A), IC7.7 (OUT_2), K3.1
unnamed: D7.2 (A), D14.2 (A), IC6.7 (OUT_2), K2.3
unnamed: D9.2 (A), D15.2 (A), IC8.7 (OUT_2), K3.3
unnamed: IC2.5 (1Y1), U6.13 (6A)
unnamed: IC2.6 (1Y2), U6.11 (5A)
unnamed: IC2.7 (1Y3), U6.9 (4A)
unnamed: IC2.9 (2Y3), U6.5 (3A)
unnamed: IC2.10 (2Y2), U6.3 (2A)
unnamed: IC2.11 (2Y1), U6.1 (1A)
unnamed: IC3.2 (INPUT), U6.12 (6Y)
unnamed: IC4.2 (INPUT), U6.10 (5Y)
unnamed: IC5.2 (INPUT), U6.8 (4Y)
unnamed: IC6.2 (INPUT), U6.2 (1Y)
unnamed: IC7.2 (INPUT), U6.4 (2Y)
unnamed: IC8.2 (INPUT), U6.6 (3Y)
POS_output: K1.6, K1.8, K2.6; also elsewhere on the board
Panel_A: K2.5; also elsewhere on the board
Panel_B: K1.7; also elsewhere on the board
Panel_C: K1.5, K3.5; also elsewhere on the board
Panel_D: K2.7, K3.7

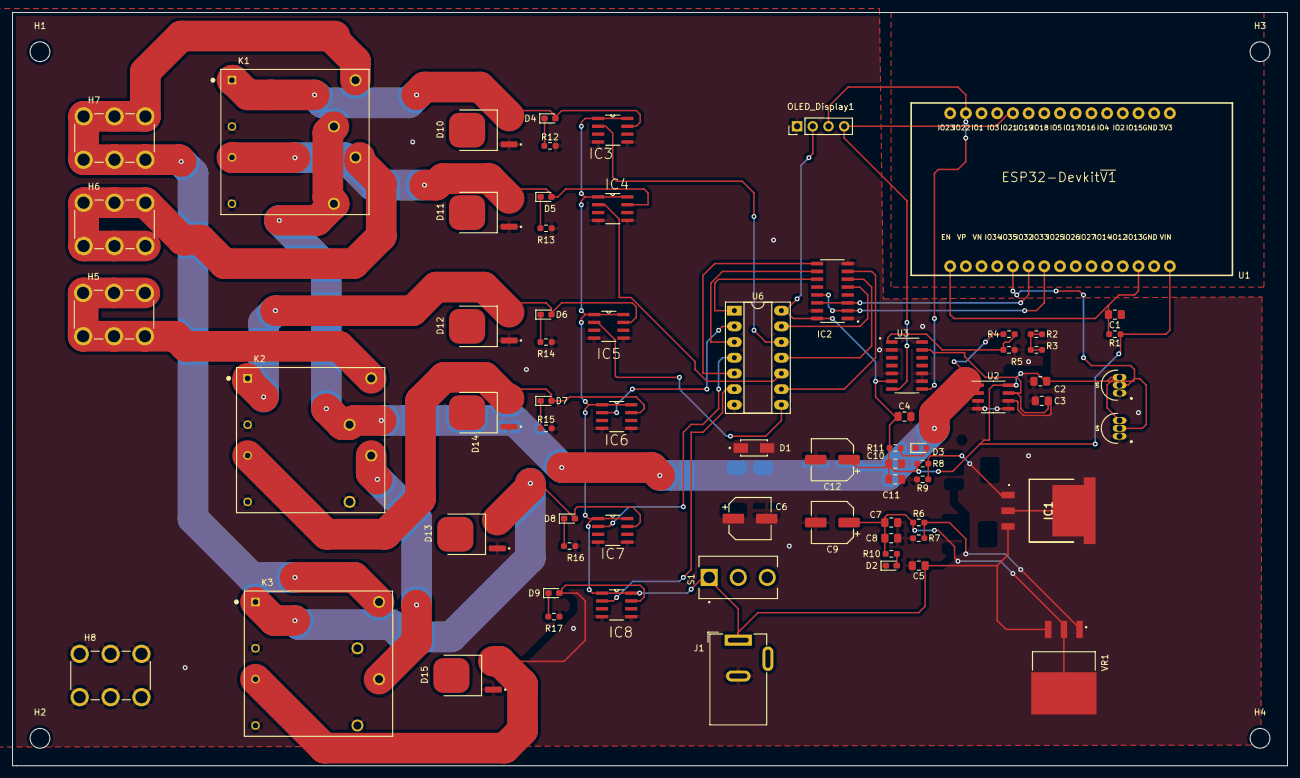
[picture p19: board notebooks/msafi2/old pcb designs/old board versions/Final_Project.kic… from above]

Board: 2 copper layers, 206.4 x 121.9 mm, 73 parts (0 on the bottom side), 46 nets.
