NikhilMSeb/ECE445-FA21-Solar/(commit log)

2021-11-01 Updating working parts of Django framework
2021-11-09 Updating src folder with documentation and Arduino folder
2021-11-09 Updating Arduino Code README
2021-11-10 Create PCB_files
2021-11-13 Updating ESP32 POST files (basic)
2021-11-13 Adding notes to Notebook Entries for updating (ESP32)
2021-11-14 Reformatting ESP32 Microcontroller Section
2021-11-14 Relay Board Name Update
2021-11-15 PCB Updates
2021-11-16 Voltage Monitoring
2021-11-16 I2C Communication with ESP32
2021-11-18 Power Subsystem LTSpice Simulations
2021-11-19 Relay Subsystem Operation
2021-11-19 Finalized Relay Subsystem
2021-11-19 Typo in Relay Subsystem Fix
2021-11-19 Added Entry Link for Finalized Relay Subsystem
2021-11-20 Code for Power Subsystem Calculations
2021-11-20 Create Darlington Array ESP32 Communication.md
2021-11-22 Create MCP3428 ESP32 Communication.md
2021-11-22 Update MCP3428 ESP32 Communication.md
2021-11-28 PCB Retrieval and Additional Testing
2021-11-30 ADC Testing and New Problems
2021-11-30 Rearranging Team Docs
    [Final_Project.kicad_pcb, Final_Project.sch, Micro-controller.sch, Micro_controller.sch, Microcontroller.sch, monitoring.sch, power_subsystem.sch, relay_config.sch]
2021-11-30 Updating Arduino programming so far
2021-11-30 Current Sensor
2021-12-03 Fixes and Current Sensor Calibration
2021-12-10 Arduino Code README typo
